Poppy-Robotics/vrb/vrb.pdf

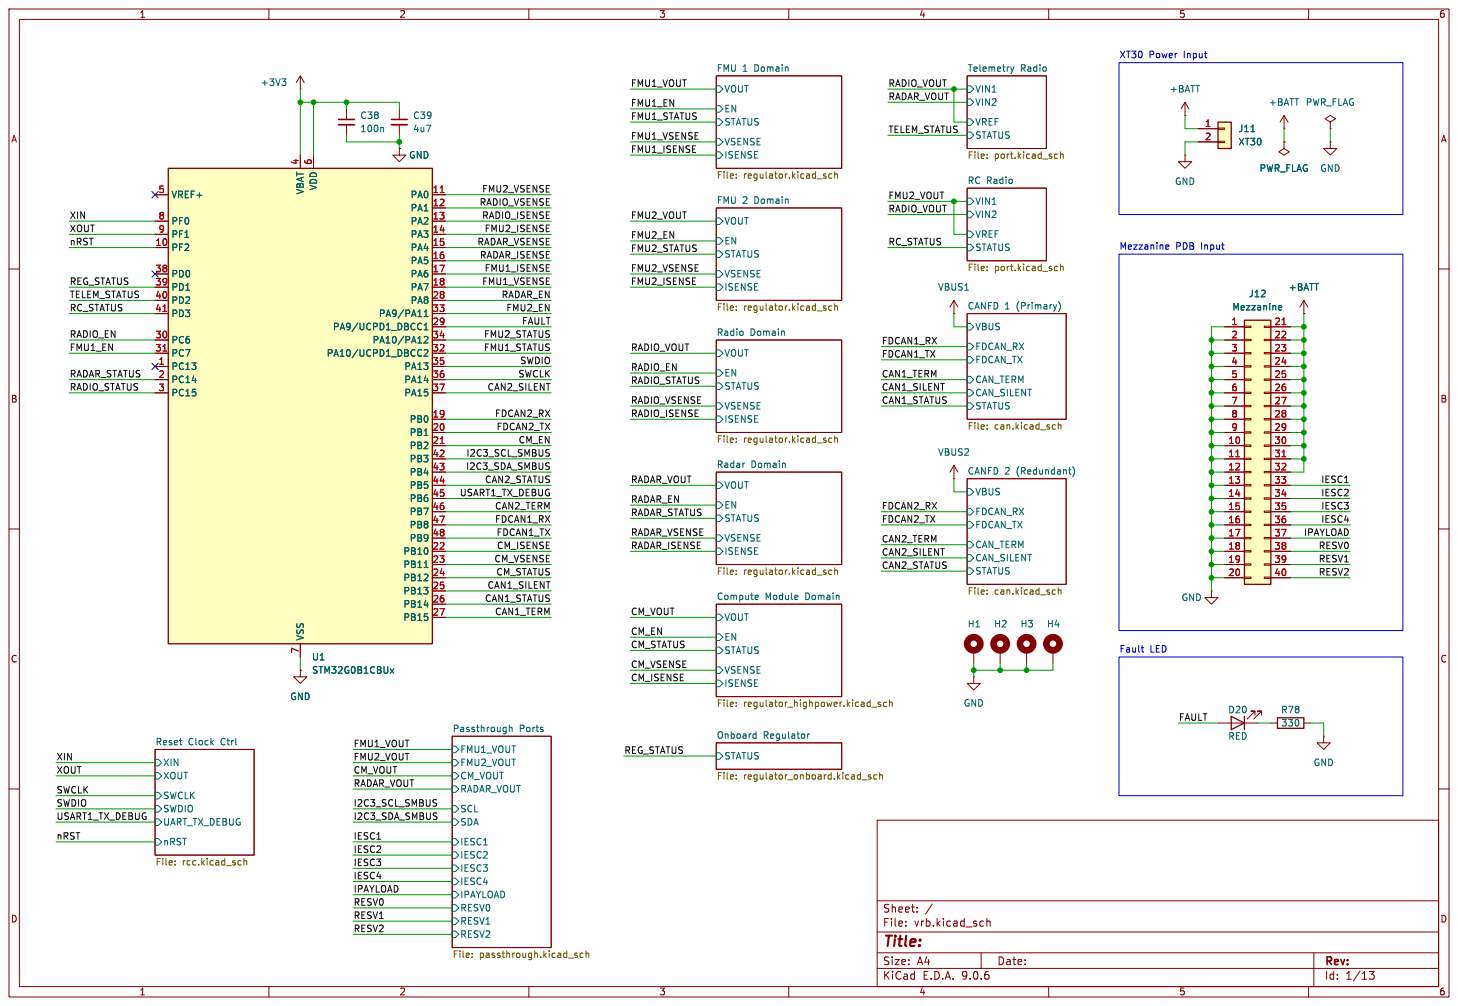
[picture p1: page 1]

+BATT GND
VBUS CANFD 1 (Primary) File: can.kicad_sch STATUS

FMU 1 Domain File: regulator.kicad_sch EN

VOUT VSENSE Compute Module Domain File: regulator_highpower.kicad_sch EN
STATUS

VIN1 VIN2 VREF RC Radio File: port.kicad_sch STATUS

FMU2_VSENSE
RADIO_VSENSE
FMU2_ISENSE RADIO_ISENSE RADAR_ISENSE
VOUT VSENSE Radar Domain File: regulator.kicad_sch STATUS Onboard Regulator File: regulator_onboard.kicad_sch EN

VOUT VSENSE Radio Domain File: regulator.kicad_sch CM_VOUT
FMU2_STATUS
FMU1_STATUS

VBUS CANFD 2 (Redundant) File: can.kicad_sch

Id: 1/13 Title: File: vrb.kicad_sch Sheet: /

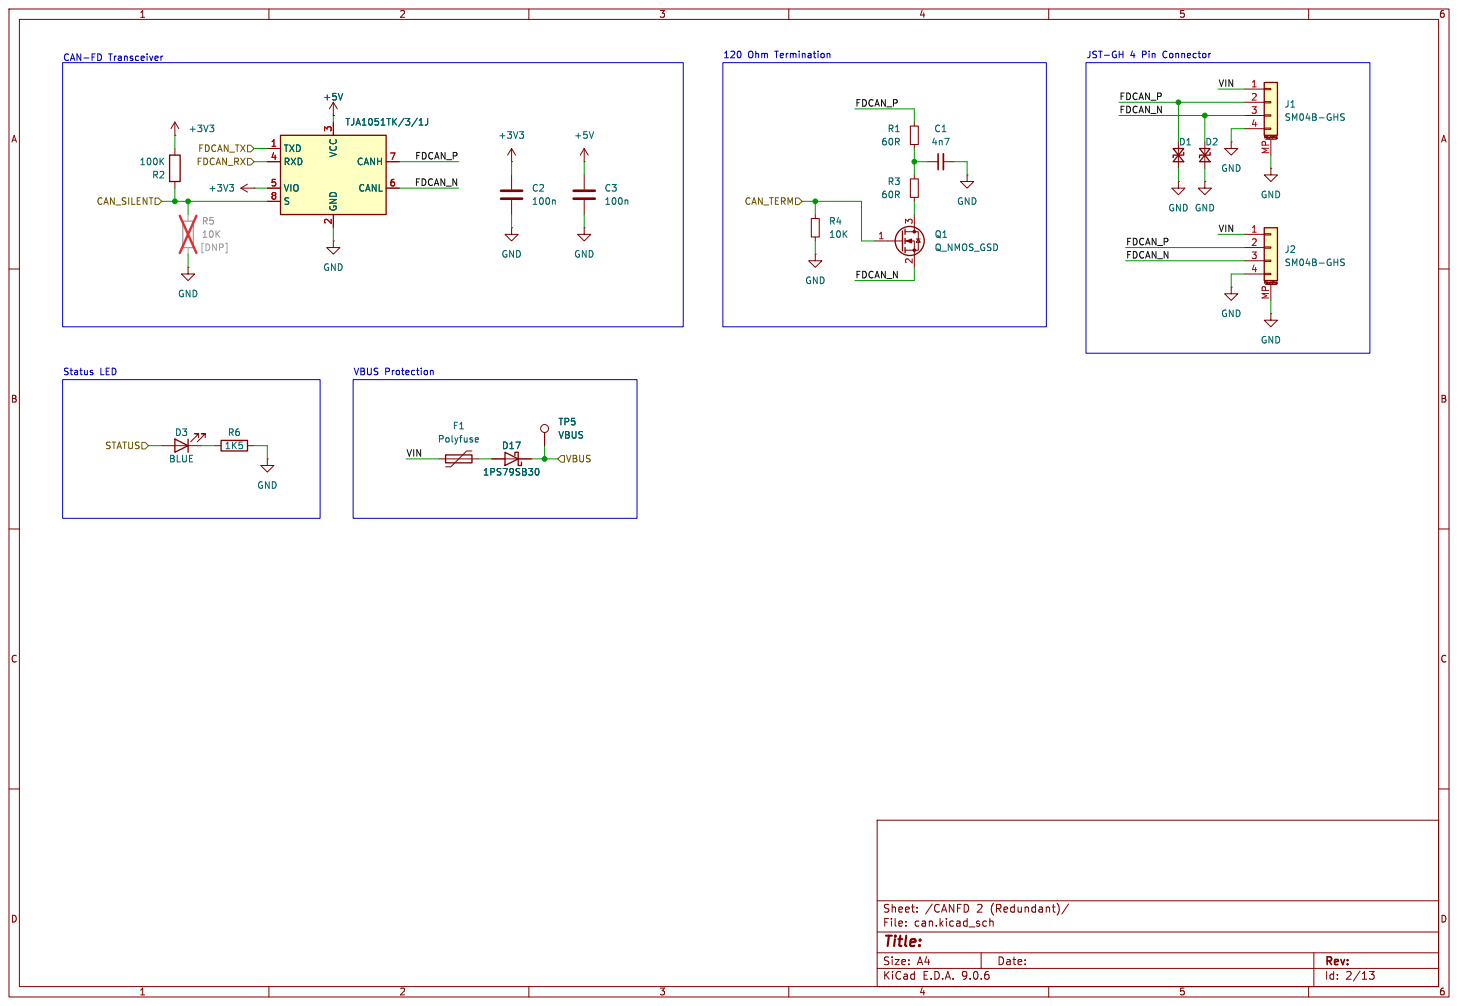
[picture p2: page 2]

2 CANH 7 CANL 6 TJA1051TK/3/1J +5V D1 D2 GND GND

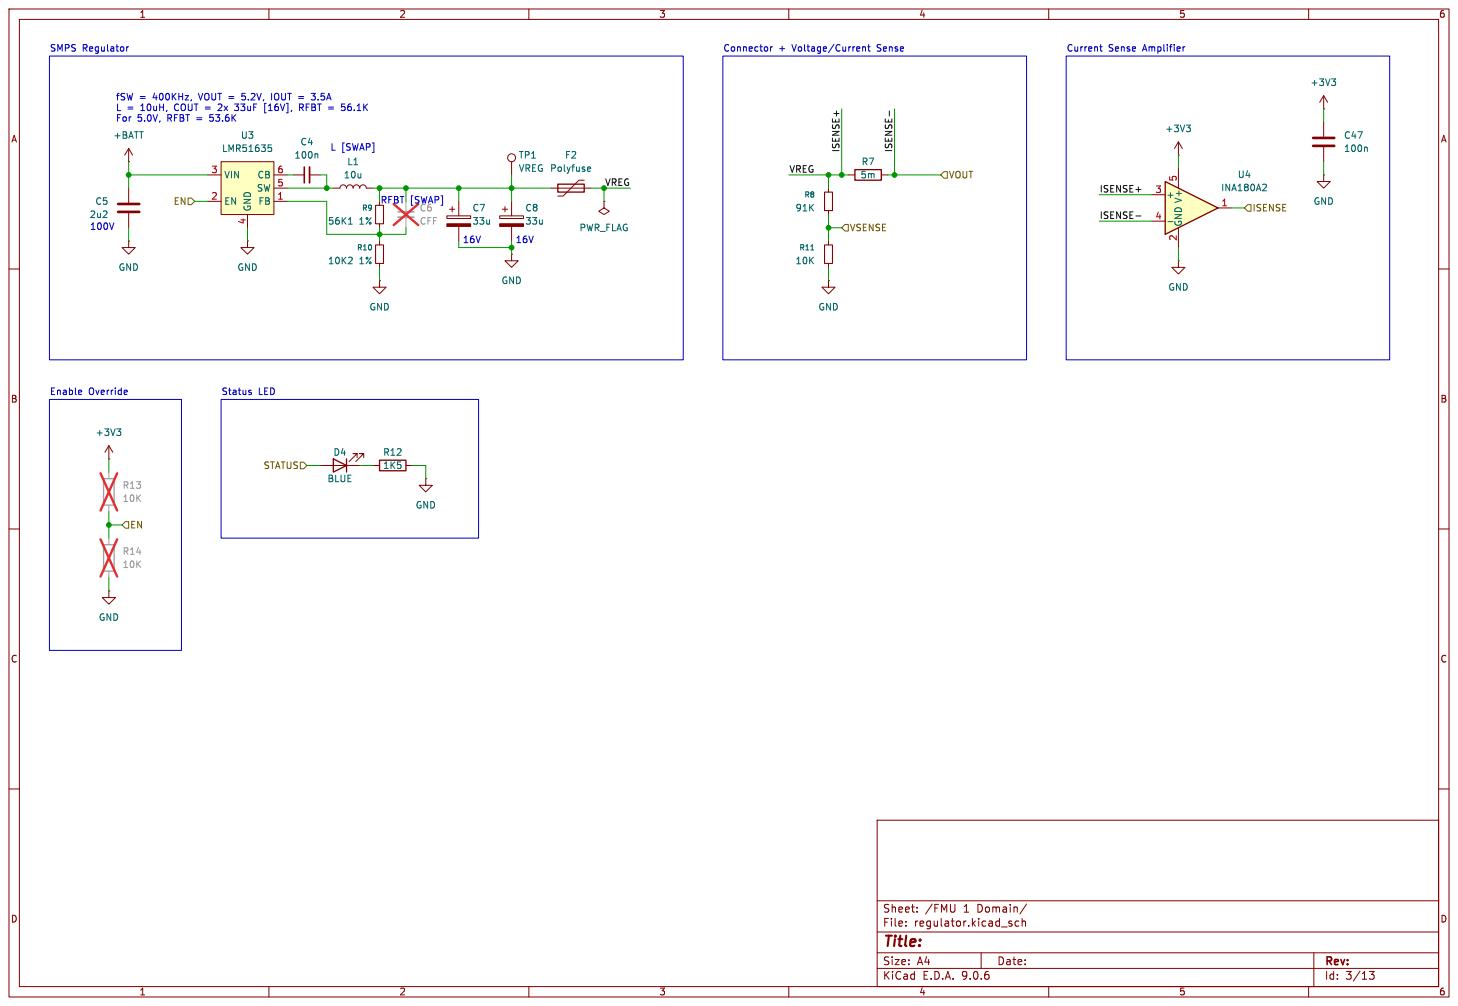
[picture p3: page 3]

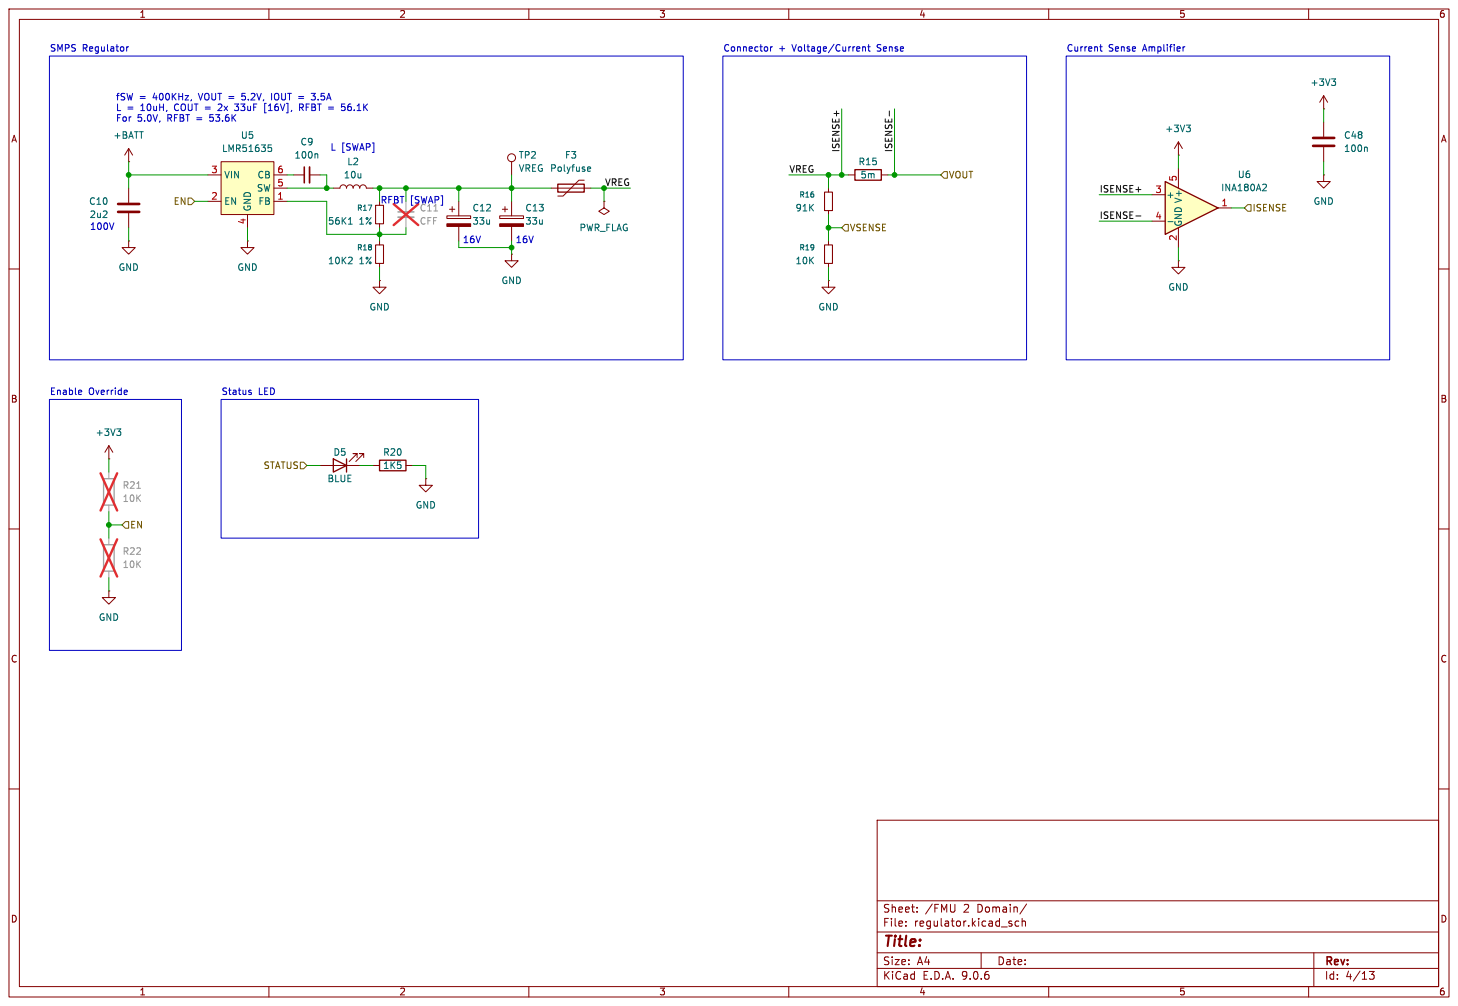
[picture p4: page 4]

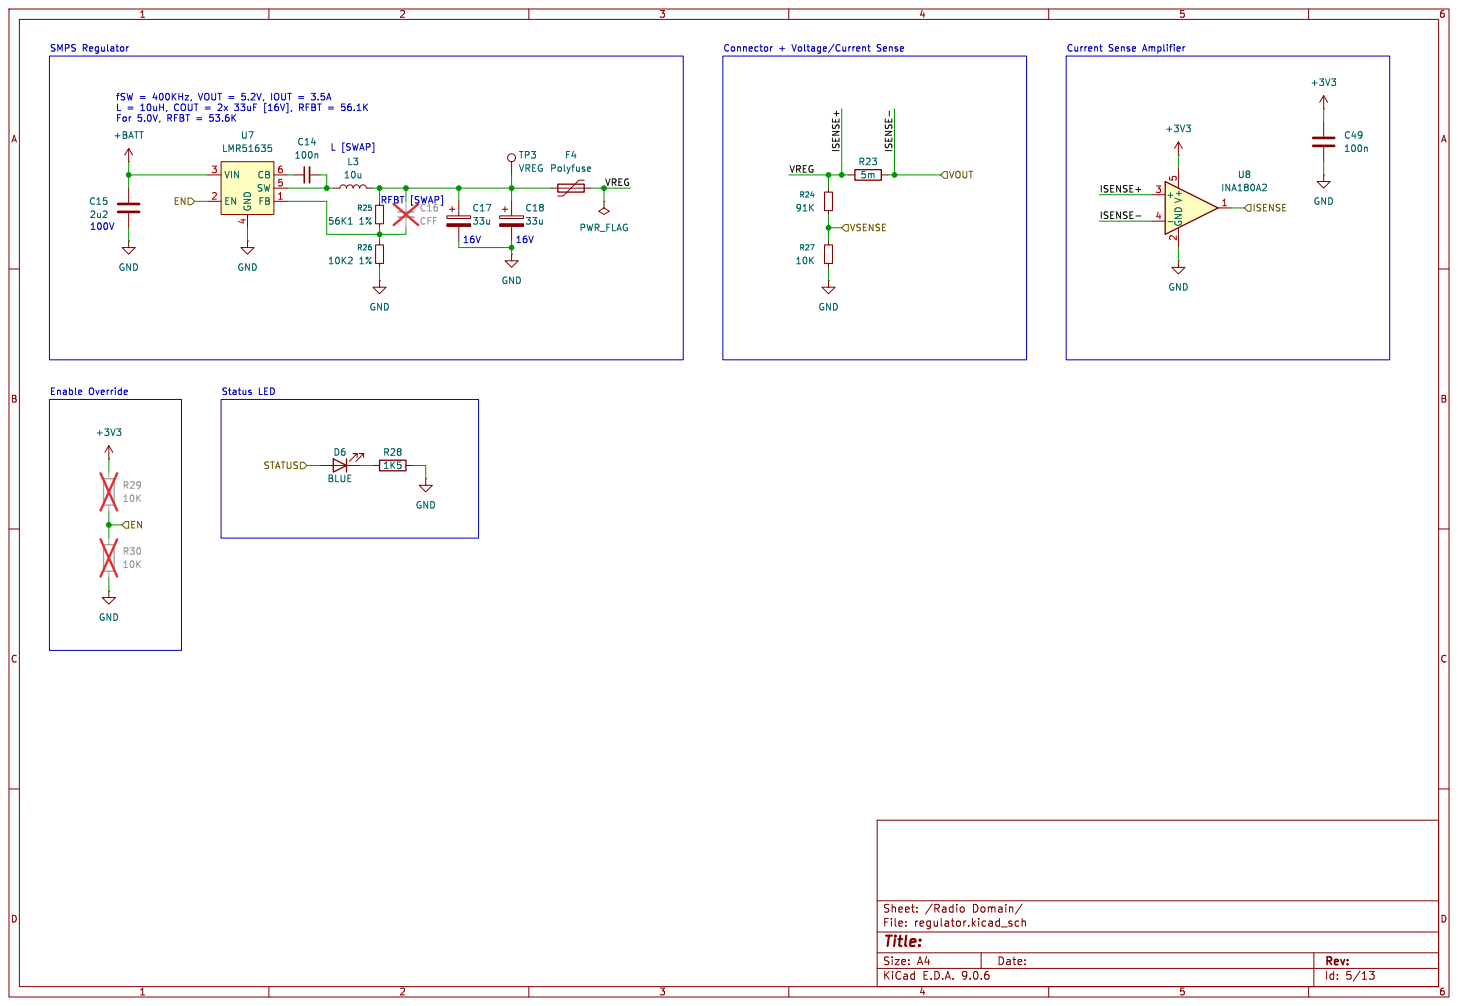
[picture p5: page 5]

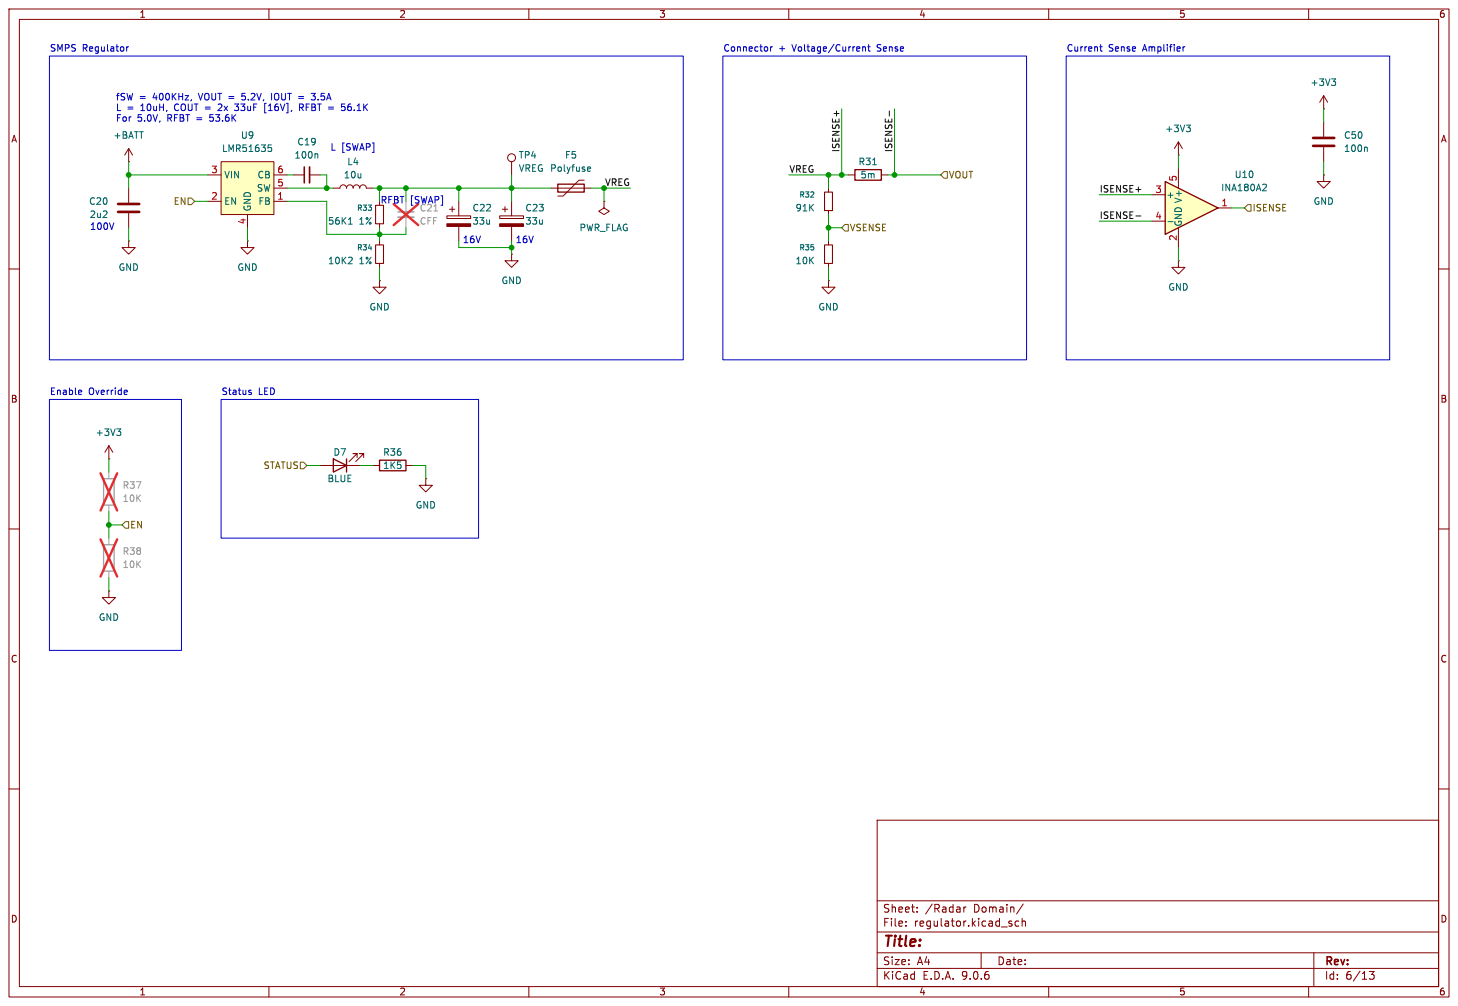
[picture p6: page 6]

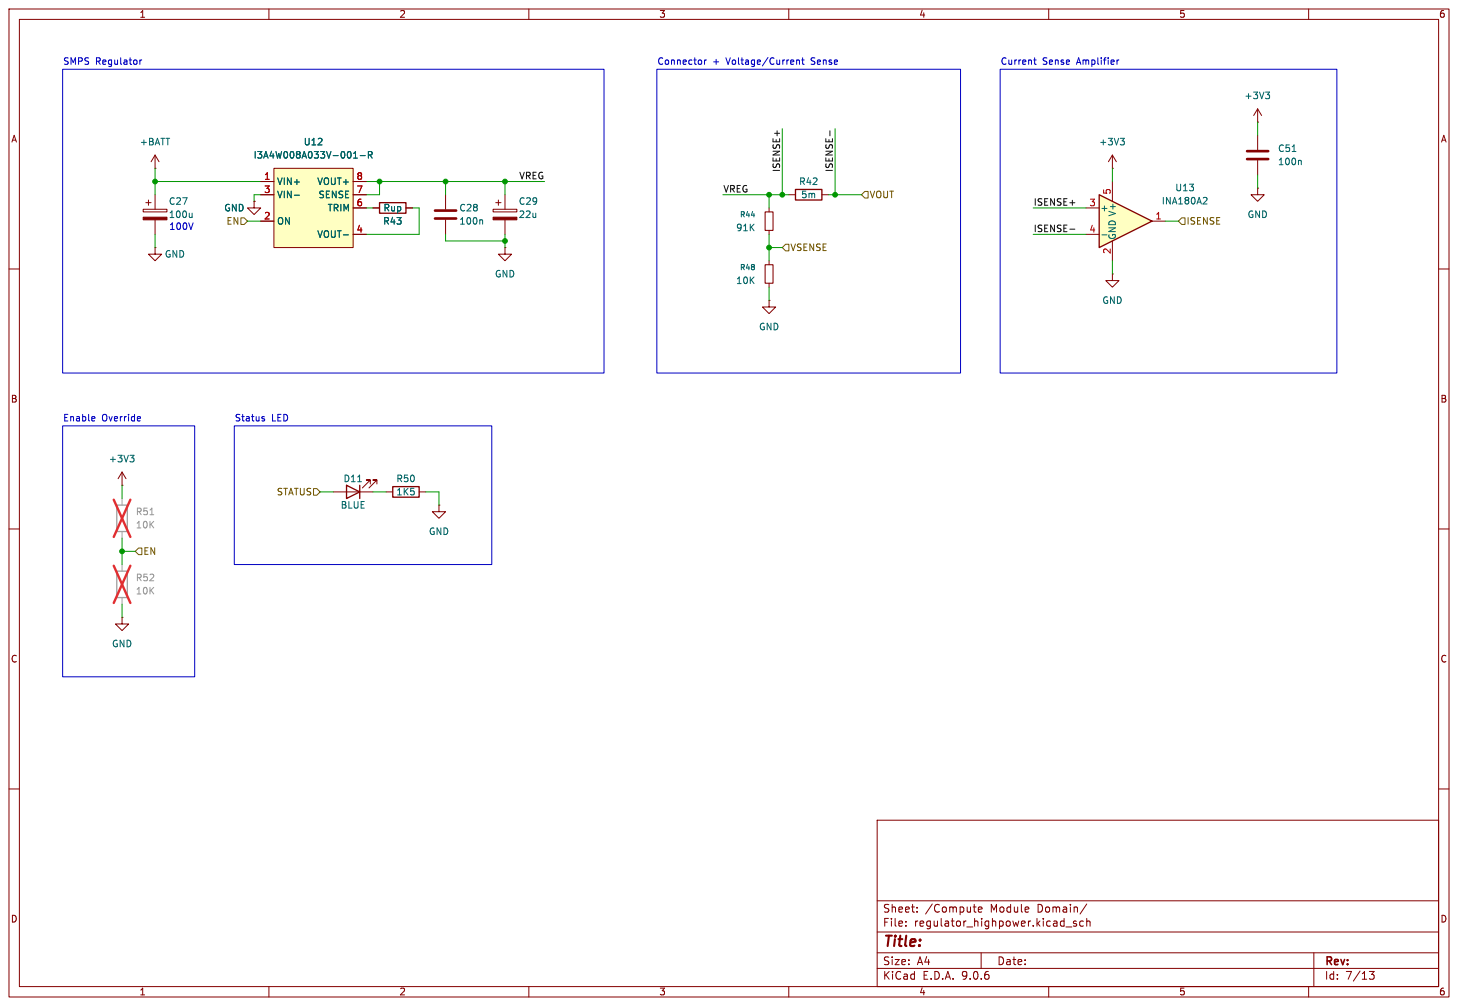
[picture p7: page 7]

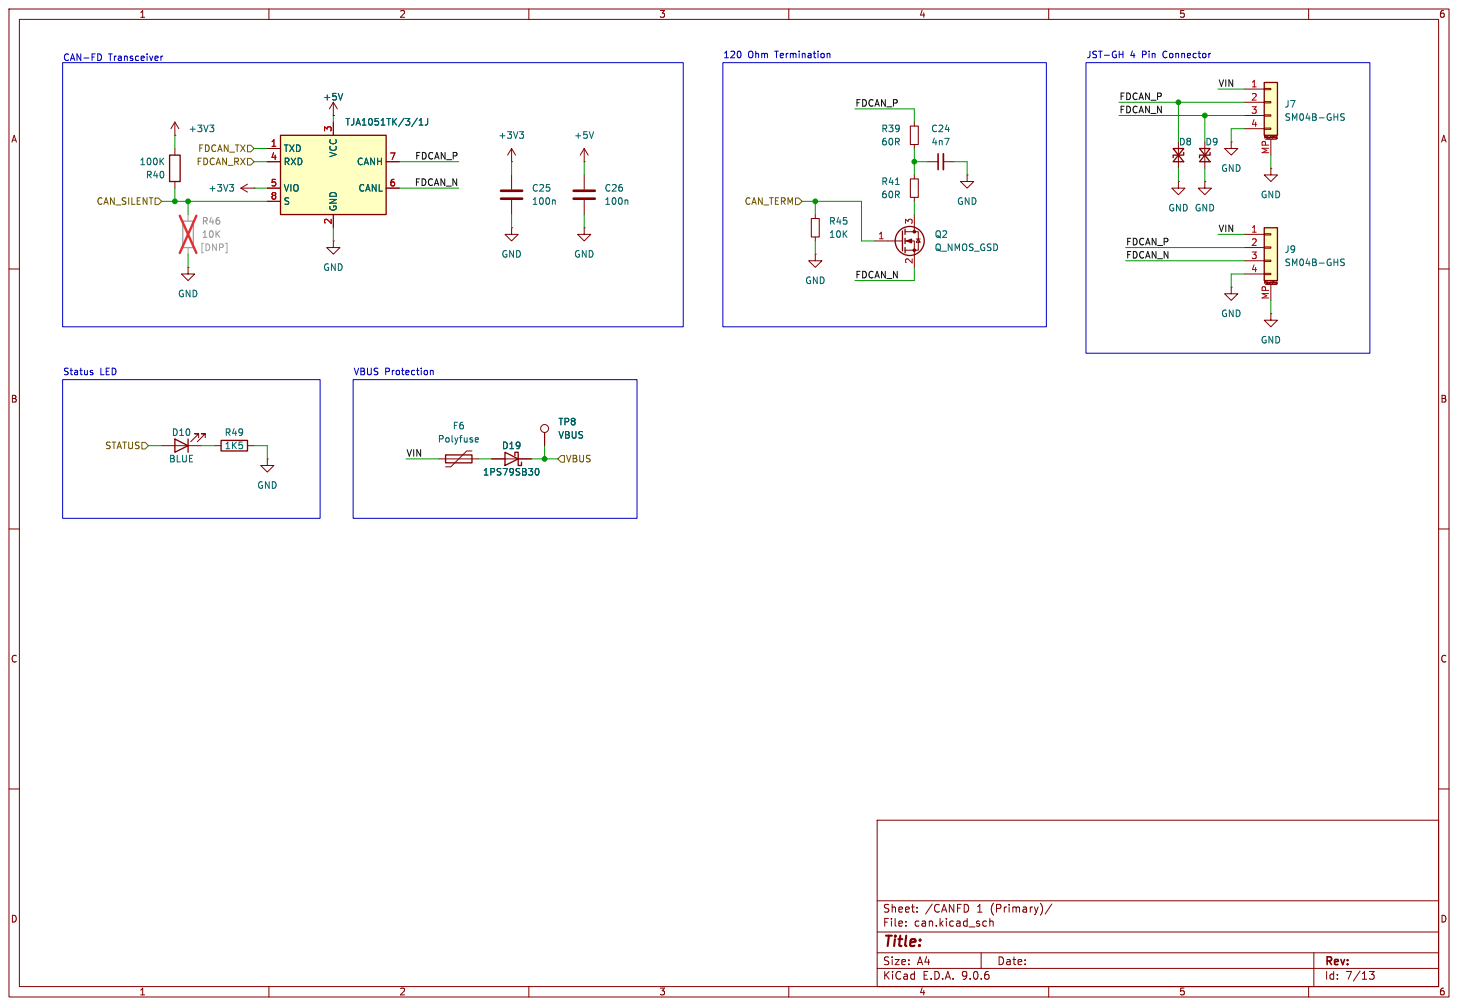
[picture p8: page 8]

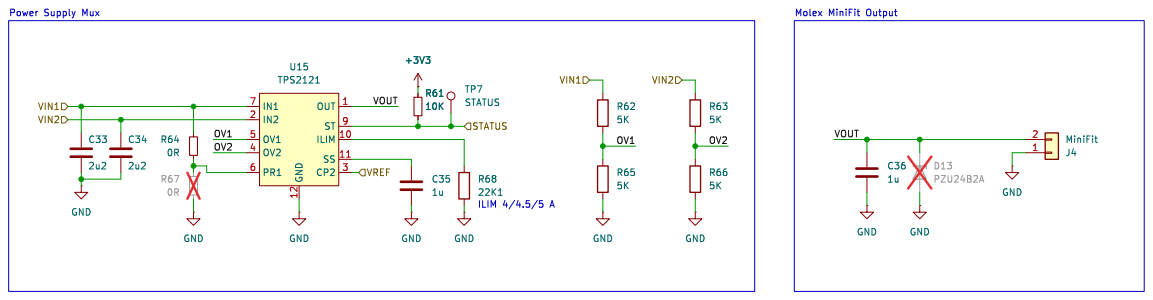
[picture p9: page 9]

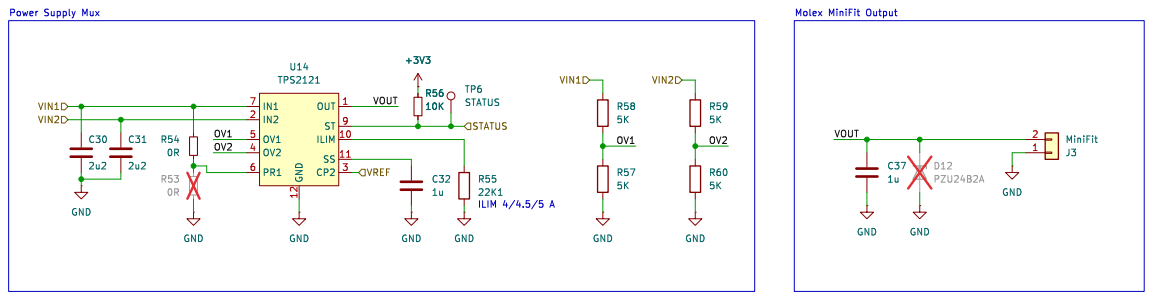
[picture p10: page 10]

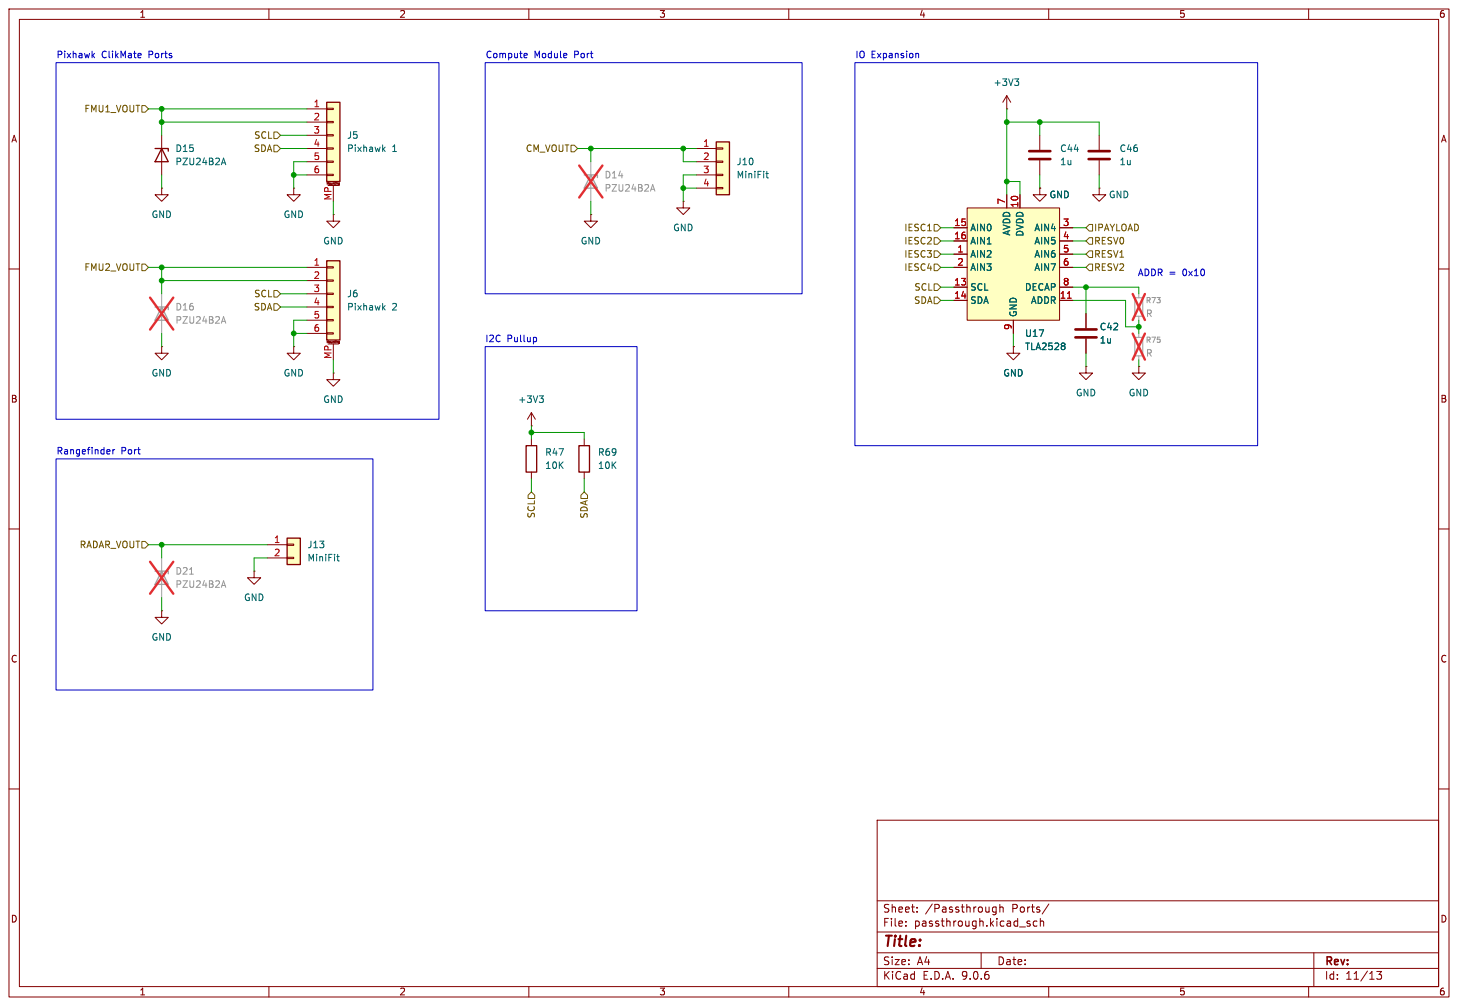
[picture p11: page 11]

9 DVDD 10 AIN4 3 AIN5 4 AIN6 5 AIN7 6 DECAP 8 ADDR 11 U17 TLA2528 GND GND

9 DVDD 10 AIN4 3 AIN5 4 AIN6 5 AIN7 6 DECAP 8 ADDR 11 GND

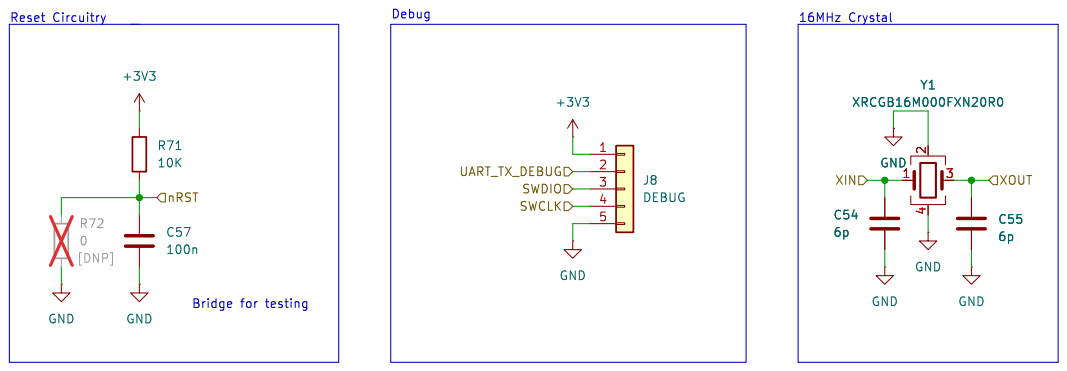
[picture p12: page 12]

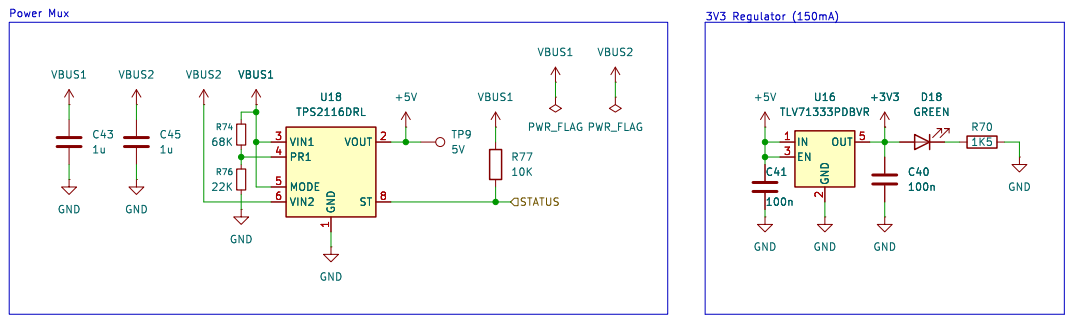
[picture p13: page 13]
