Poppy-Robotics/vrb/vrb.kicad_pcb

## KiCad design vrb.kicad_pcb (2026-01-10)

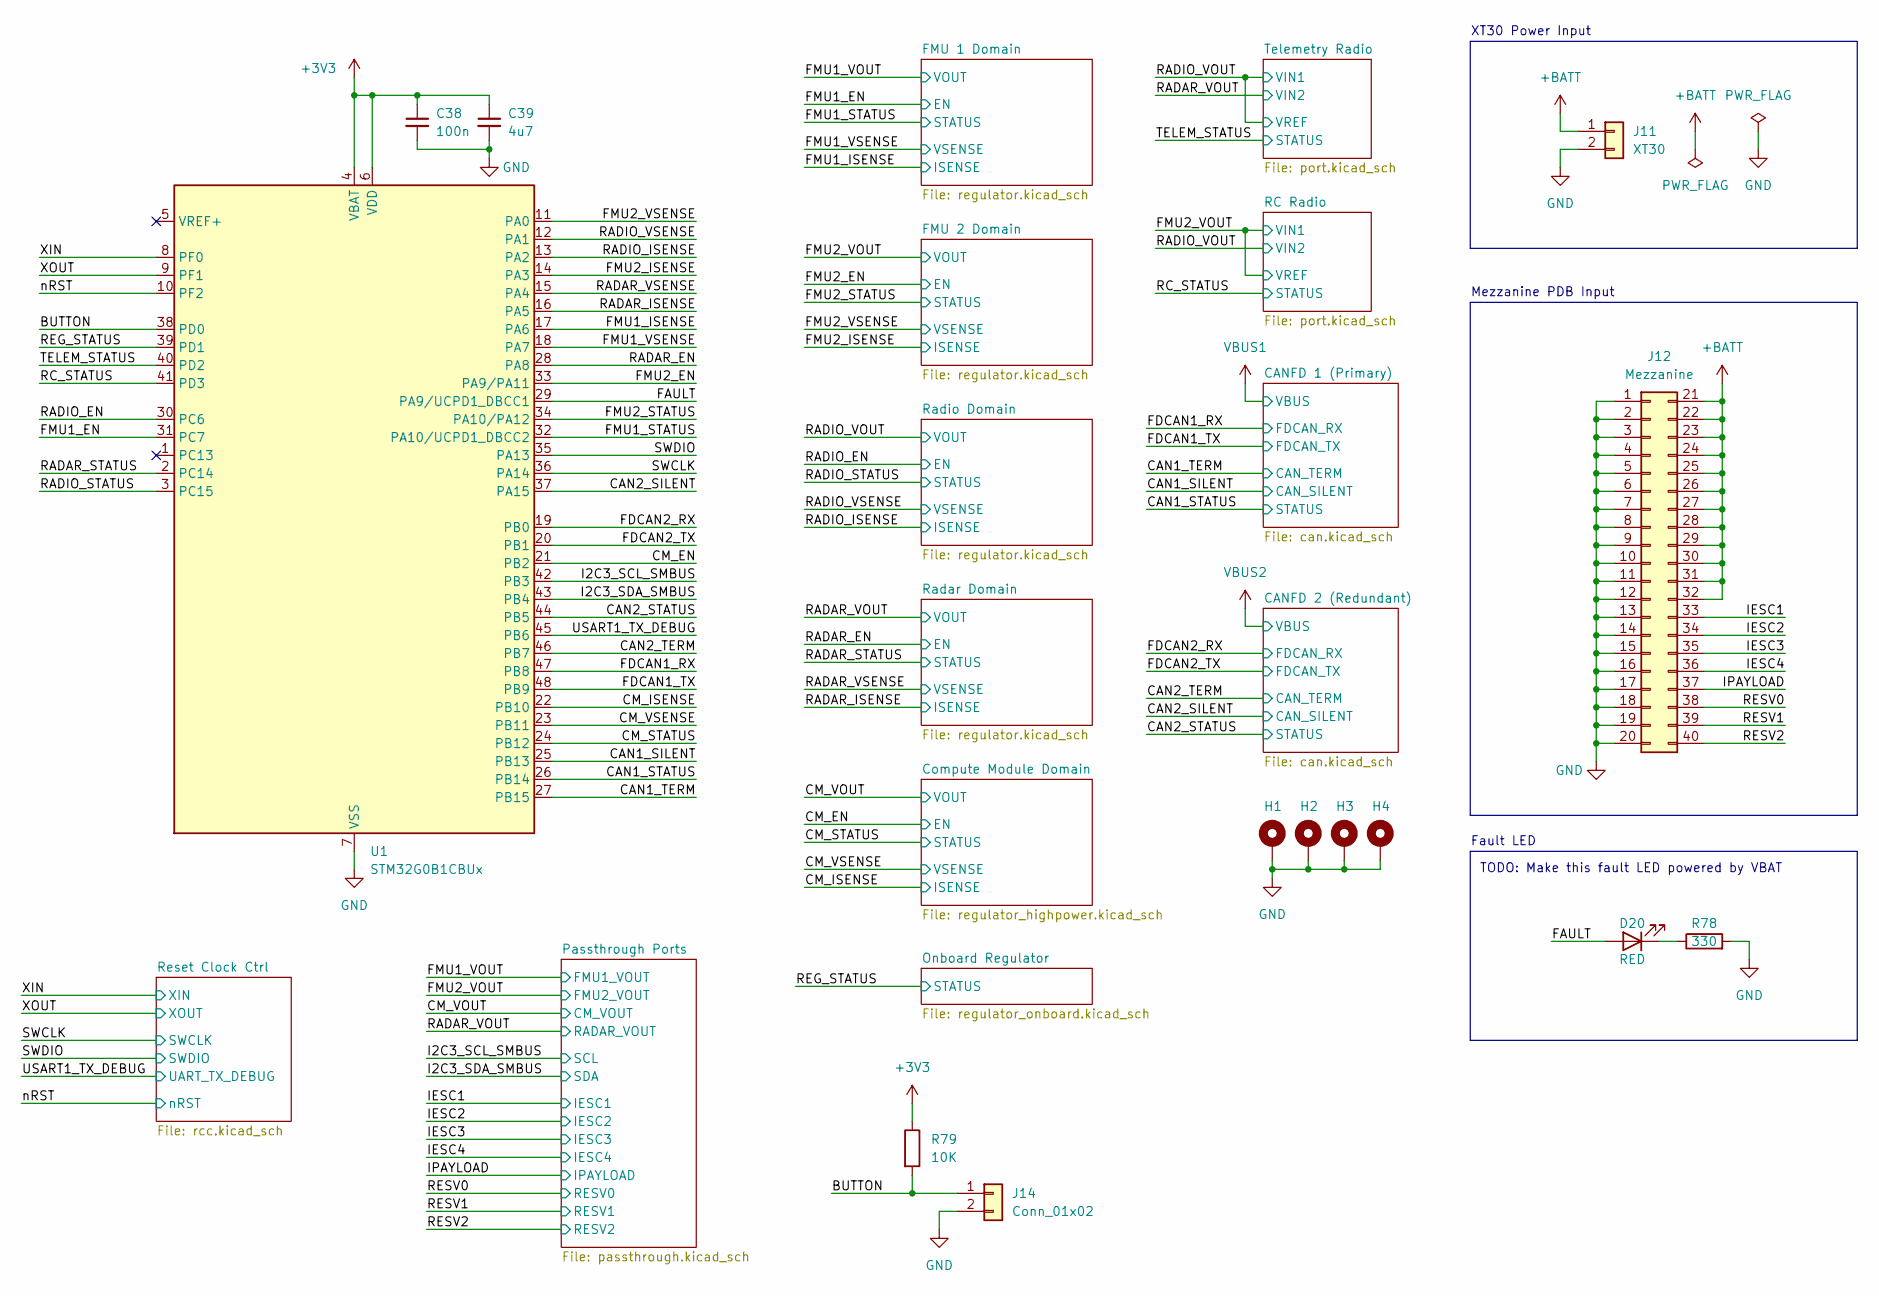
[picture p14: schematic vrb.kicad_sch]

Parts:
C38: 100n; C_0402_1005Metric
C39: 4u7; C_0402_1005Metric
D20: RED; LED_0603_1608Metric
H1, H2, H3, H4: MountingHole_Pad; MountingHole_3.2mm_M3_Pad_Via
J11: XT30; AMASS_XT30PW-M_1x02_P2.50mm_Horizontal
J12: Mezzanine; CON_528850474_MOL
J14: Conn_01x02; PinHeader_1x02_P2.54mm_Vertical
R78: 330; R_0402_1005Metric
R79: 10K; R_0402_1005Metric
U1: STM32G0B1CBUx; QFN-48-1EP_7x7mm_P0.5mm_EP5.6x5.6mm

Connections:
+BATT: J11.1, J12.21, J12.22, J12.23, J12.24, J12.25, J12.26, J12.27, J12.28, J12.29, J12.30, J12.31, J12.32; also elsewhere on the board
/BUTTON: J14.1, R79.2, U1.38 (PD0)
/CAN1_SILENT: U1.25 (PB13); also elsewhere on the board
/CAN1_STATUS: U1.26 (PB14); also elsewhere on the board
/CAN1_TERM: U1.27 (PB15); also elsewhere on the board
/CAN2_SILENT: U1.37 (PA15); also elsewhere on the board
/CAN2_STATUS: U1.44 (PB5); also elsewhere on the board
/CAN2_TERM: U1.46 (PB7); also elsewhere on the board
/CM_EN: U1.21 (PB2); also elsewhere on the board
/CM_ISENSE: U1.22 (PB10); also elsewhere on the board
/CM_STATUS: U1.24 (PB12); also elsewhere on the board
/CM_VSENSE: U1.23 (PB11); also elsewhere on the board
/FAULT: D20.2 (A), U1.29 (PA9/UCPD1_DBCC1)
/FDCAN1_RX: U1.47 (PB8); also elsewhere on the board
/FDCAN1_TX: U1.48 (PB9); also elsewhere on the board
/FDCAN2_RX: U1.19 (PB0); also elsewhere on the board
/FDCAN2_TX: U1.20 (PB1); also elsewhere on the board
/FMU1_EN: U1.31 (PC7); also elsewhere on the board
/FMU1_ISENSE: U1.17 (PA6); also elsewhere on the board
/FMU1_STATUS: U1.32 (PA10/UCPD1_DBCC2); also elsewhere on the board
/FMU1_VSENSE: U1.18 (PA7); also elsewhere on the board
/FMU2_EN: U1.33 (PA9/PA11); also elsewhere on the board
/FMU2_ISENSE: U1.14 (PA3); also elsewhere on the board
/FMU2_STATUS: U1.34 (PA10/PA12); also elsewhere on the board
/FMU2_VSENSE: U1.11 (PA0); also elsewhere on the board
/I2C3_SCL_SMBUS: U1.42 (PB3); also elsewhere on the board
/I2C3_SDA_SMBUS: U1.43 (PB4); also elsewhere on the board
/IESC1: J12.33; also elsewhere on the board
/IESC2: J12.34; also elsewhere on the board
/IESC3: J12.35; also elsewhere on the board
/IESC4: J12.36; also elsewhere on the board
/IPAYLOAD: J12.37; also elsewhere on the board
/RADAR_EN: U1.28 (PA8); also elsewhere on the board
/RADAR_ISENSE: U1.16 (PA5); also elsewhere on the board
/RADAR_STATUS: U1.2 (PC14); also elsewhere on the board
/RADAR_VSENSE: U1.15 (PA4); also elsewhere on the board
/RADIO_EN: U1.30 (PC6); also elsewhere on the board
/RADIO_ISENSE: U1.13 (PA2); also elsewhere on the board
/RADIO_STATUS: U1.3 (PC15); also elsewhere on the board
/RADIO_VSENSE: U1.12 (PA1); also elsewhere on the board
/RC_STATUS: U1.41 (PD3); also elsewhere on the board
/REG_STATUS: U1.39 (PD1); also elsewhere on the board
/RESV0: J12.38; also elsewhere on the board
/RESV1: J12.39; also elsewhere on the board
/RESV2: J12.40; also elsewhere on the board
/SWCLK: U1.36 (PA14); also elsewhere on the board
/SWDIO: U1.35 (PA13); also elsewhere on the board
/TELEM_STATUS: U1.40 (PD2); also elsewhere on the board
/USART1_TX_DEBUG: U1.45 (PB6); also elsewhere on the board
/XIN: U1.8 (PF0); also elsewhere on the board
/XOUT: U1.9 (PF1); also elsewhere on the board
/nRST: U1.10 (PF2); also elsewhere on the board
unnamed: D20.1 (K), R78.1

Notes on the sheet:
TODO: Make this fault LED powered by VBAT
Fault LED
XT30 Power Input
Mezzanine PDB Input

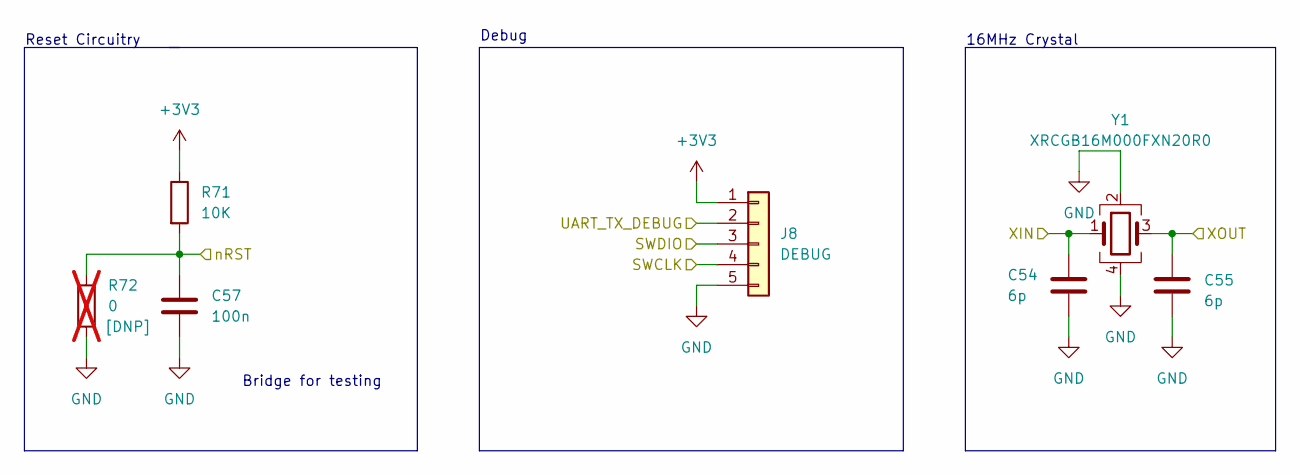
[picture p15: schematic rcc.kicad_sch]

Parts:
C54, C55: 6p; C_0402_1005Metric; LCSC C466231
C57: 100n; C_0402_1005Metric; LCSC C907967
J8: DEBUG; PinHeader_1x05_P2.54mm_Vertical
R71: 10K; R_0402_1005Metric; LCSC C102690
R72: 0; R_0402_1005Metric; not fitted
Y1: XRCGB16M000FXN20R0; Crystal_SMD_2016-4Pin_2.0x1.6mm; Part XRCGB16M000FXN20R0; LCSC C907977

Connections:
/SWCLK: J8.4; also elsewhere on the board
/SWDIO: J8.3; also elsewhere on the board
/USART1_TX_DEBUG: J8.2; also elsewhere on the board
/XIN: C54.1, Y1.1; also elsewhere on the board
/XOUT: C55.1, Y1.3; also elsewhere on the board
/nRST: C57.1, R71.2, R72.1; also elsewhere on the board

Notes on the sheet:
Reset Circuitry
Bridge for testing
16MHz Crystal
Debug

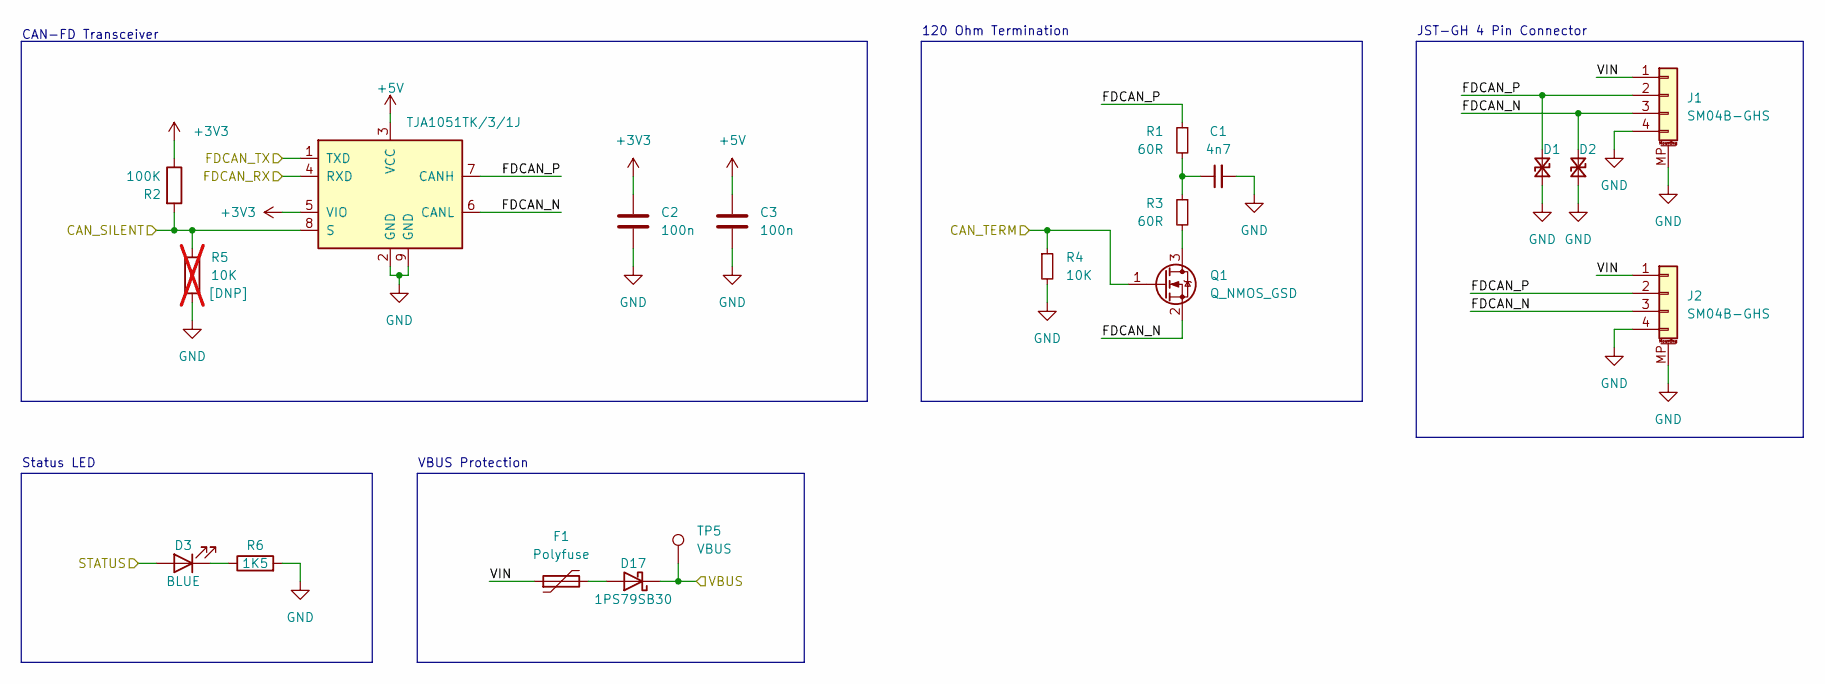
[picture p16: schematic can.kicad_sch]

Parts:
C1: 4n7; C_0402_1005Metric
C2, C3: 100n; C_0402_1005Metric
D1, D2: D_TVS_Small; Nexperia_DSN0603-2_0.6x0.3mm_P0.4mm
D3: BLUE; LED_0603_1608Metric
D17: 1PS79SB30; D_SOD-523; LCSC C426690
F1: Polyfuse; Fuse_1206_3216Metric
J1, J2: SM04B-GHS; JST_GH_SM04B-GHS-TB_1x04-1MP_P1.25mm_Horizontal
Q1: Q_NMOS_GSD; SOT-23-3
R1, R3: 60R; R_0402_1005Metric
R2: 100K; R_0402_1005Metric
R4: 10K; R_0402_1005Metric
R5: 10K; R_0402_1005Metric; not fitted
R6: 1K5; R_0402_1005Metric
TP5: VBUS; TestPoint_Pad_1.0x1.0mm
U2: TJA1051TK/3/1J; DFN-8-1EP_3x3mm_P0.65mm_EP1.55x2.4mm

Connections:
/CAN2_SILENT: R2.2, R5.1, U2.8 (S); also elsewhere on the board
/CAN2_STATUS: D3.2 (A); also elsewhere on the board
/CAN2_TERM: Q1.1 (G), R4.1; also elsewhere on the board
/CANFD 2 (Redundant)/FDCAN_N: D2.2 (A2), J1.3, J2.3, Q1.2 (S), U2.6 (CANL)
/CANFD 2 (Redundant)/FDCAN_P: D1.2 (A2), J1.2, J2.2, R1.1, U2.7 (CANH)
/CANFD 2 (Redundant)/VIN: F1.1, J1.1, J2.1
/FDCAN2_RX: U2.4 (RXD); also elsewhere on the board
/FDCAN2_TX: U2.1 (TXD); also elsewhere on the board
unnamed: C1.1, R1.2, R3.1
unnamed: D3.1 (K), R6.1
unnamed: D17.2 (A), F1.2
unnamed: Q1.3 (D), R3.2
VBUS2: D17.1 (K), TP5.1; also elsewhere on the board

Parts of its further copies:
C24: 4n7; C_0402_1005Metric
C25, C26: 100n; C_0402_1005Metric
D8, D9: D_TVS_Small; Nexperia_DSN0603-2_0.6x0.3mm_P0.4mm
D10: BLUE; LED_0603_1608Metric
D19: 1PS79SB30; D_SOD-523; LCSC C426690
F6: Polyfuse; Fuse_1206_3216Metric
J7, J9: SM04B-GHS; JST_GH_SM04B-GHS-TB_1x04-1MP_P1.25mm_Horizontal
Q2: Q_NMOS_GSD; SOT-23-3
R39, R41: 60R; R_0402_1005Metric
R40: 100K; R_0402_1005Metric
R45: 10K; R_0402_1005Metric
R46: 10K; R_0402_1005Metric; not fitted
R49: 1K5; R_0402_1005Metric
TP8: VBUS; TestPoint_Pad_1.0x1.0mm
U11: TJA1051TK/3/1J; DFN-8-1EP_3x3mm_P0.65mm_EP1.55x2.4mm

Connections of its further copies:
/CAN1_SILENT: R40.2, R46.1, U11.8 (S); also elsewhere on the board
/CAN1_STATUS: D10.2 (A); also elsewhere on the board
/CAN1_TERM: Q2.1 (G), R45.1; also elsewhere on the board
/CANFD 1 (Primary)/FDCAN_N: D9.2 (A2), J7.3, J9.3, Q2.2 (S), U11.6 (CANL)
/CANFD 1 (Primary)/FDCAN_P: D8.2 (A2), J7.2, J9.2, R39.1, U11.7 (CANH)
/CANFD 1 (Primary)/VIN: F6.1, J7.1, J9.1
/FDCAN1_RX: U11.4 (RXD); also elsewhere on the board
/FDCAN1_TX: U11.1 (TXD); also elsewhere on the board
unnamed: C24.1, R39.2, R41.1
unnamed: D10.1 (K), R49.1
unnamed: D19.2 (A), F6.2
unnamed: Q2.3 (D), R41.2
VBUS1: D19.1 (K), TP8.1; also elsewhere on the board

Notes on the sheet:
CAN-FD Transceiver
JST-GH 4 Pin Connector
Status LED
VBUS Protection
120 Ohm Termination

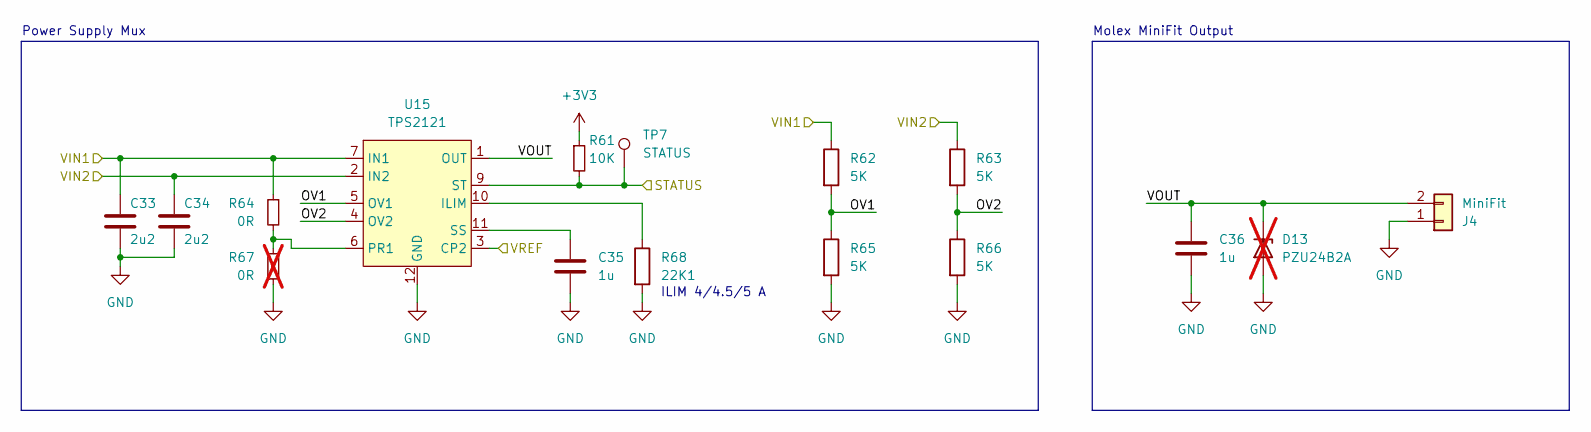
[picture p17: schematic port.kicad_sch]

Parts:
C33, C34: 2u2; C_0603_1608Metric
C35, C36: 1u; C_0603_1608Metric
D13: PZU24B2A; D_SOD-323F; not fitted
J4: MiniFit; Molex_Mini-Fit_Jr_5569-02A2_2x01_P4.20mm_Horizontal
R61: 10K; R_0402_1005Metric
R62, R63: 5K; R_0603_1608Metric
R64: 0R; R_0603_1608Metric
R65, R66: 5K; R_0402_1005Metric
R67: 0R; R_0402_1005Metric; not fitted
R68: 22K1; R_0603_1608Metric
TP7: STATUS; TestPoint_Pad_1.0x1.0mm
U15: TPS2121; Texas_VQFN-HR-12_2x2.5mm_P0.5mm

Connections:
/FMU2_VOUT: C33.1, R62.1, R64.1, U15.3 (CP2), U15.7 (IN1); also elsewhere on the board
/RADIO_VOUT: C34.1, R63.1, U15.2 (IN2); also elsewhere on the board
/RC Radio/OV1: R62.2, R65.1, U15.5 (OV1)
/RC Radio/OV2: R63.2, R66.1, U15.4 (OV2)
/RC Radio/VOUT: C36.1, D13.1 (K), J4.2, U15.1 (OUT), U15.8 (OUT)
/RC_STATUS: R61.2, TP7.1, U15.9 (ST); also elsewhere on the board
unnamed: R68.1, U15.10 (ILIM)
unnamed: R64.2, R67.1, U15.6 (PR1)
unnamed: C35.1, U15.11 (SS)

Parts of its further copies:
C30, C31: 2u2; C_0603_1608Metric
C32, C37: 1u; C_0603_1608Metric
D12: PZU24B2A; D_SOD-323F; not fitted
J3: MiniFit; Molex_Mini-Fit_Jr_5569-02A2_2x01_P4.20mm_Horizontal
R53: 0R; R_0402_1005Metric; not fitted
R54: 0R; R_0603_1608Metric
R55: 22K1; R_0603_1608Metric
R56: 10K; R_0402_1005Metric
R57, R60: 5K; R_0402_1005Metric
R58, R59: 5K; R_0603_1608Metric
TP6: STATUS; TestPoint_Pad_1.0x1.0mm
U14: TPS2121; Texas_VQFN-HR-12_2x2.5mm_P0.5mm

Connections of its further copies:
/RADAR_VOUT: C31.1, R59.1, U14.2 (IN2); also elsewhere on the board
/RADIO_VOUT: C30.1, R54.1, R58.1, U14.3 (CP2), U14.7 (IN1); also elsewhere on the board
/TELEM_STATUS: R56.2, TP6.1, U14.9 (ST); also elsewhere on the board
/Telemetry Radio/OV1: R57.1, R58.2, U14.5 (OV1)
/Telemetry Radio/OV2: R59.2, R60.1, U14.4 (OV2)
/Telemetry Radio/VOUT: C37.1, D12.1 (K), J3.2, U14.1 (OUT), U14.8 (OUT)
unnamed: R55.1, U14.10 (ILIM)
unnamed: R53.1, R54.2, U14.6 (PR1)
unnamed: C32.1, U14.11 (SS)

Notes on the sheet:
Molex MiniFit Output
Power Supply Mux
ILIM 4/4.5/5 A

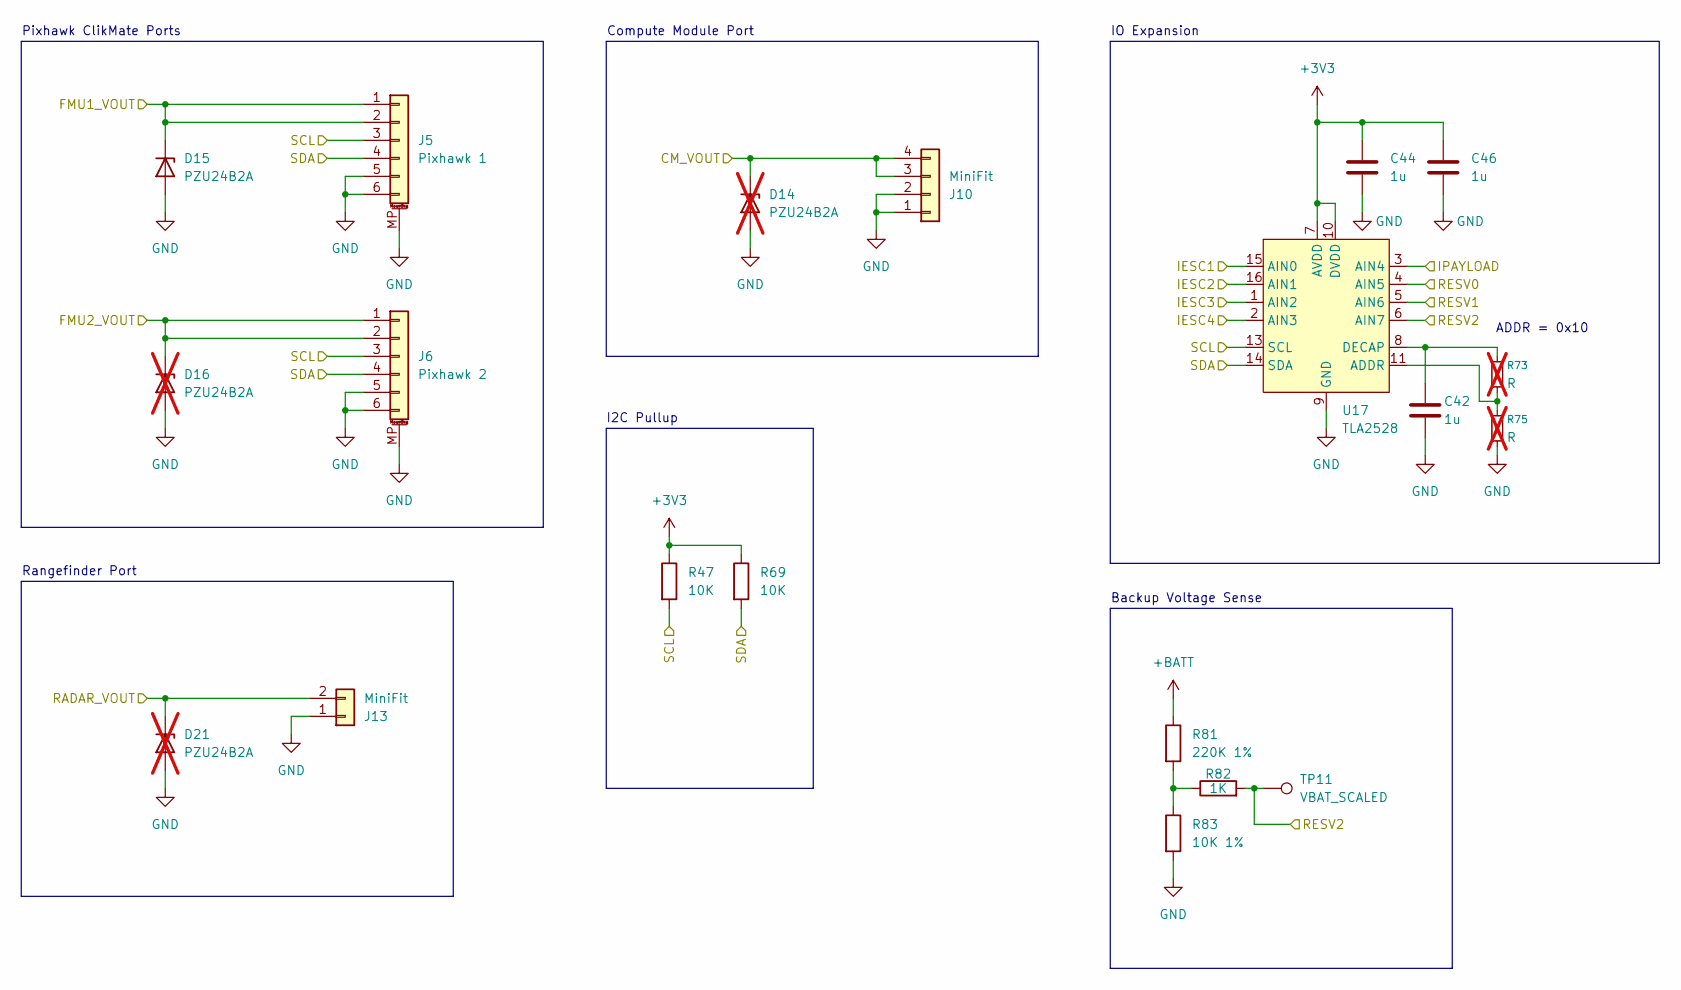
[picture p18: schematic passthrough.kicad_sch]

Parts:
C42, C44, C46: 1u; C_0402_1005Metric
D14, D16, D21: PZU24B2A; D_SOD-323F; not fitted
D15: PZU24B2A; D_SOD-323F
J5: Pixhawk 1; Molex_CLIK-Mate_502494-0670_1x06-1MP_P2.00mm_Horizontal
J6: Pixhawk 2; Molex_CLIK-Mate_502494-0670_1x06-1MP_P2.00mm_Horizontal
J10: MiniFit; Molex_Mini-Fit_Jr_5569-04A2_2x02_P4.20mm_Horizontal
J13: MiniFit; Molex_Mini-Fit_Jr_5569-02A2_2x01_P4.20mm_Horizontal
R47, R69: 10K; R_0402_1005Metric
R73, R75: R; R_0402_1005Metric; not fitted
R81: 220K 1%; R_0603_1608Metric
R82: 1K; R_0603_1608Metric
R83: 10K 1%; R_0603_1608Metric
TP11: VBAT_SCALED; TestPoint_Pad_1.5x1.5mm
U17: TLA2528; WQFN-16-1EP_3x3mm_P0.5mm_EP1.68x1.68mm

Connections:
+BATT: R81.1; also elsewhere on the board
/CM_VOUT: D14.1 (K), J10.3, J10.4; also elsewhere on the board
/FMU1_VOUT: D15.1 (K), J5.1, J5.2; also elsewhere on the board
/FMU2_VOUT: D16.1 (K), J6.1, J6.2; also elsewhere on the board
/I2C3_SCL_SMBUS: J5.3, J6.3, R47.2, U17.13 (SCL); also elsewhere on the board
/I2C3_SDA_SMBUS: J5.4, J6.4, R69.2, U17.14 (SDA); also elsewhere on the board
/IESC1: U17.15 (AIN0); also elsewhere on the board
/IESC2: U17.16 (AIN1); also elsewhere on the board
/IESC3: U17.1 (AIN2); also elsewhere on the board
/IESC4: U17.2 (AIN3); also elsewhere on the board
/IPAYLOAD: U17.3 (AIN4); also elsewhere on the board
/RADAR_VOUT: D21.1 (K), J13.2; also elsewhere on the board
/RESV0: U17.4 (AIN5); also elsewhere on the board
/RESV1: U17.5 (AIN6); also elsewhere on the board
/RESV2: R82.2, TP11.1, U17.6 (AIN7); also elsewhere on the board
unnamed: R81.2, R82.1, R83.1
unnamed: R73.2, R75.1, U17.11 (ADDR)
unnamed: C42.1, R73.1, U17.8 (DECAP)

Notes on the sheet:
Pixhawk ClikMate Ports
I2C Pullup
Rangefinder Port
Backup Voltage Sense
ADDR = 0x10
Compute Module Port
IO Expansion

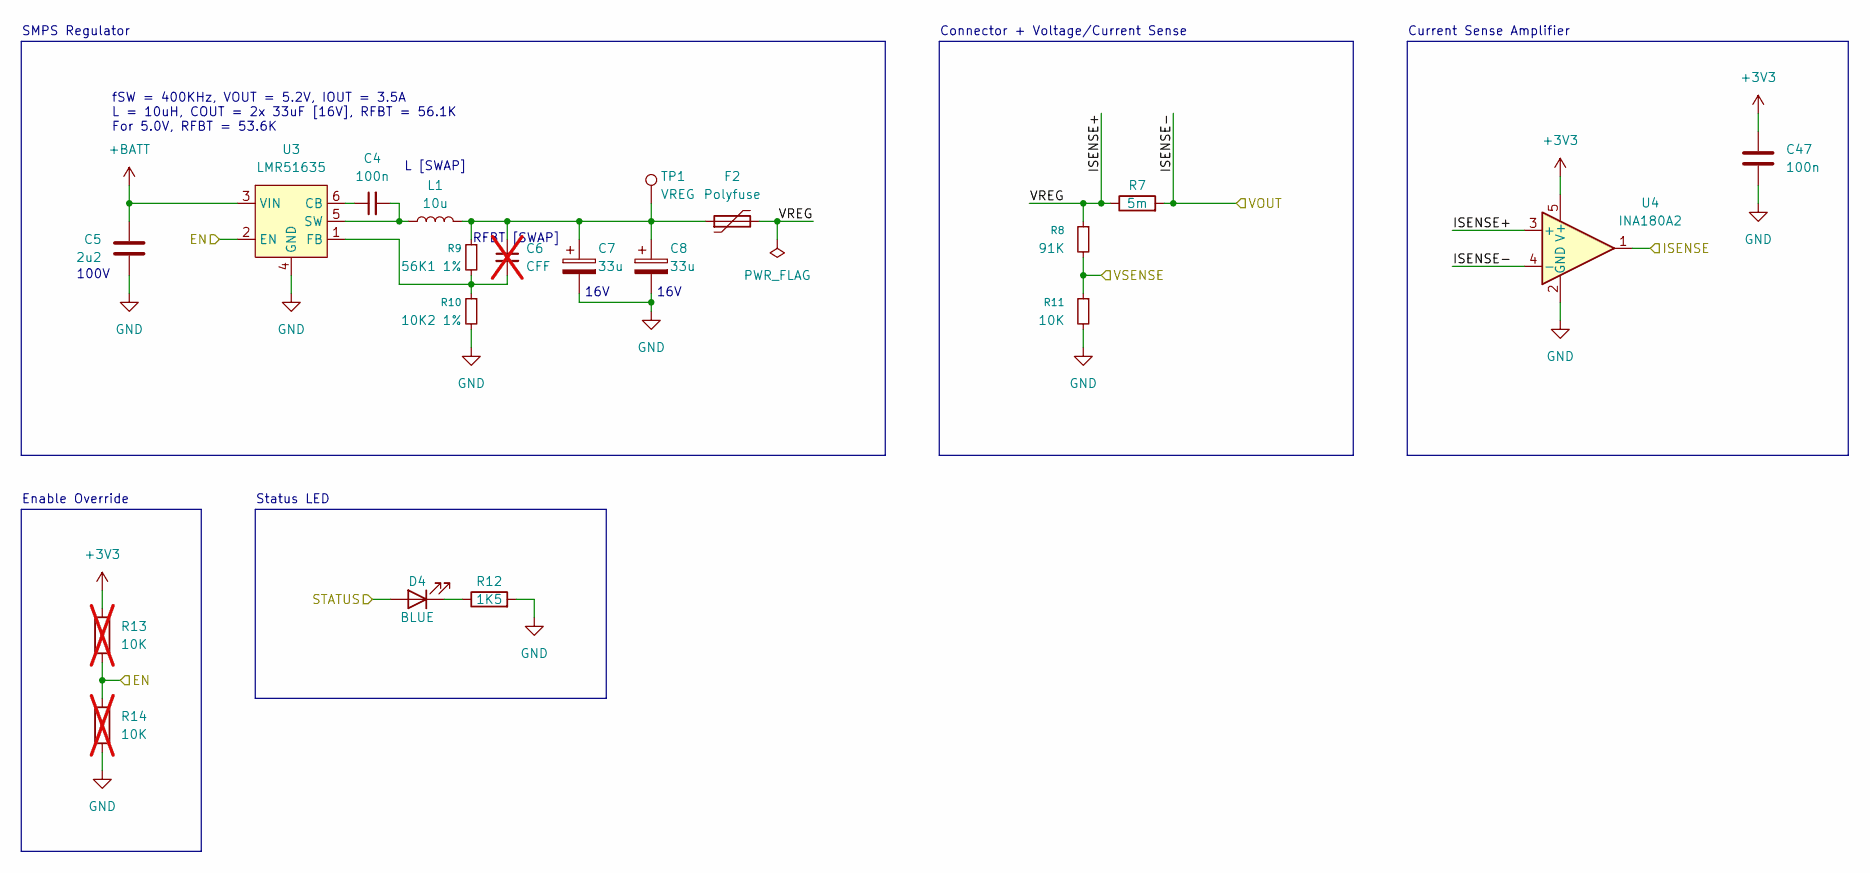
[picture p19: schematic regulator.kicad_sch]

Parts:
C4: 100n; C_0805_2012Metric
C5: 2u2; C_1206_3216Metric
C6: CFF; C_0805_2012Metric; not fitted
C7, C8: 33u; CP_EIA-3528-12_Kemet-T
C47: 100n; C_0402_1005Metric
D4: BLUE; LED_0603_1608Metric
F2: Polyfuse; Fuse_1206_3216Metric
L1: 10u; L_Bourns_SRP7028A_7.3x6.6mm
R7: 5m; R_1206_3216Metric
R8: 91K; R_0402_1005Metric
R9: 56K1 1%; R_0603_1608Metric
R10: 10K2 1%; R_0603_1608Metric
R11: 10K; R_0402_1005Metric
R12: 1K5; R_0402_1005Metric
R13, R14: 10K; R_0603_1608Metric; not fitted
TP1: VREG; TestPoint_Pad_2.0x2.0mm
U3: LMR51635; SOT-23-6
U4: INA180A2; SOT-23-5

Connections:
+BATT: C5.1, U3.3 (VIN); also elsewhere on the board
/FMU1_EN: R13.2, R14.1, U3.2 (EN); also elsewhere on the board
/FMU1_ISENSE: U4.1; also elsewhere on the board
/FMU1_STATUS: D4.2 (A); also elsewhere on the board
/FMU1_VOUT: R7.2, U4.4 (-); also elsewhere on the board
/FMU1_VSENSE: R8.2, R11.1; also elsewhere on the board
/FMU 1 Domain/ISENSE+: F2.2, R7.1, R8.1, U4.3 (+)
unnamed: C6.1, C7.1, C8.1, F2.1, L1.2, R9.1, TP1.1
unnamed: D4.1 (K), R12.1
unnamed: C4.1, U3.6 (CB)
unnamed: C6.2, R9.2, R10.1, U3.1 (FB)
unnamed: C4.2, L1.1, U3.5 (SW)

Parts of its further copies:
C9, C14, C19: 100n; C_0805_2012Metric
C10, C15, C20: 2u2; C_1206_3216Metric
C11, C16, C21: CFF; C_0805_2012Metric; not fitted
C12, C13, C17, C18, C22, C23: 33u; CP_EIA-3528-12_Kemet-T
C48, C49, C50: 100n; C_0402_1005Metric
D5, D6, D7: BLUE; LED_0603_1608Metric
F3, F4, F5: Polyfuse; Fuse_1206_3216Metric
L2, L3, L4: 10u; L_Bourns_SRP7028A_7.3x6.6mm
R15, R23, R31: 5m; R_1206_3216Metric
R16, R24, R32: 91K; R_0402_1005Metric
R17, R25, R33: 56K1 1%; R_0603_1608Metric
R18, R26, R34: 10K2 1%; R_0603_1608Metric
R19, R27, R35: 10K; R_0402_1005Metric
R20, R28, R36: 1K5; R_0402_1005Metric
R21, R22, R29, R30, R37, R38: 10K; R_0603_1608Metric; not fitted
TP2, TP3, TP4: VREG; TestPoint_Pad_2.0x2.0mm
U5, U7, U9: LMR51635; SOT-23-6
U6, U8, U10: INA180A2; SOT-23-5

Connections of its further copies:
+BATT: C10.1, C15.1, C20.1, U5.3 (VIN), U7.3 (VIN), U9.3 (VIN); also elsewhere on the board
/FMU2_EN: R21.2, R22.1, U5.2 (EN); also elsewhere on the board
/FMU2_ISENSE: U6.1; also elsewhere on the board
/FMU2_STATUS: D5.2 (A); also elsewhere on the board
/FMU2_VOUT: R15.2, U6.4 (-); also elsewhere on the board
/FMU2_VSENSE: R16.2, R19.1; also elsewhere on the board
/FMU 2 Domain/ISENSE+: F3.2, R15.1, R16.1, U6.3 (+)
/RADAR_EN: R37.2, R38.1, U9.2 (EN); also elsewhere on the board
/RADAR_ISENSE: U10.1; also elsewhere on the board
/RADAR_STATUS: D7.2 (A); also elsewhere on the board
/RADAR_VOUT: R31.2, U10.4 (-); also elsewhere on the board
/RADAR_VSENSE: R32.2, R35.1; also elsewhere on the board
/RADIO_EN: R29.2, R30.1, U7.2 (EN); also elsewhere on the board
/RADIO_ISENSE: U8.1; also elsewhere on the board
/RADIO_STATUS: D6.2 (A); also elsewhere on the board
/RADIO_VOUT: R23.2, U8.4 (-); also elsewhere on the board
/RADIO_VSENSE: R24.2, R27.1; also elsewhere on the board
/Radar Domain/ISENSE+: F5.2, R31.1, R32.1, U10.3 (+)
/Radio Domain/ISENSE+: F4.2, R23.1, R24.1, U8.3 (+)
unnamed: C11.1, C12.1, C13.1, F3.1, L2.2, R17.1, TP2.1
unnamed: C16.1, C17.1, C18.1, F4.1, L3.2, R25.1, TP3.1
unnamed: C21.1, C22.1, C23.1, F5.1, L4.2, R33.1, TP4.1
unnamed: D5.1 (K), R20.1
unnamed: D6.1 (K), R28.1
unnamed: D7.1 (K), R36.1
unnamed: C9.1, U5.6 (CB)
unnamed: C11.2, R17.2, R18.1, U5.1 (FB)
unnamed: C9.2, L2.1, U5.5 (SW)
unnamed: C14.1, U7.6 (CB)
unnamed: C16.2, R25.2, R26.1, U7.1 (FB)
unnamed: C14.2, L3.1, U7.5 (SW)
unnamed: C19.1, U9.6 (CB)
unnamed: C21.2, R33.2, R34.1, U9.1 (FB)
unnamed: C19.2, L4.1, U9.5 (SW)

Notes on the sheet:
Enable Override
16V
Status LED
Current Sense Amplifier
L [SWAP]
RFBT [SWAP]
SMPS Regulator
Connector + Voltage/Current Sense
fSW = 400KHz, VOUT = 5.2V, IOUT = 3.5A L = 10uH, COUT = 2x 33uF [16V], RFBT = 56.1K For 5.0V, RFBT = 53.6K
100V

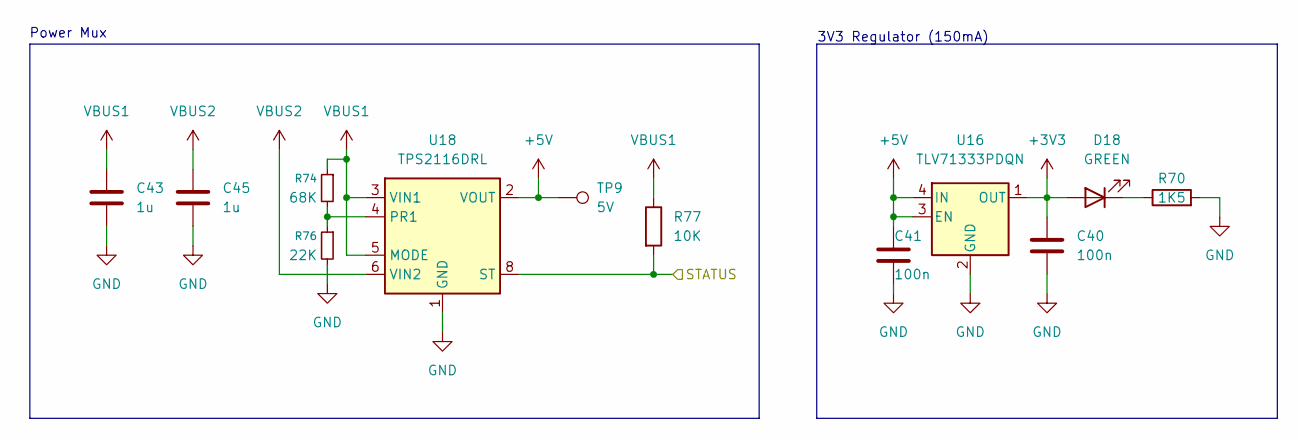
[picture p20: schematic regulator_onboard.kicad_sch]

Parts:
C40, C41: 100n; C_0603_1608Metric; LCSC C282519
C43, C45: 1u; C_0603_1608Metric
D18: GREEN; LED_0603_1608Metric; Part QBLP595-IG; LCSC C2856703
R70: 1K5; R_0402_1005Metric; LCSC C25930
R74: 68K; R_0402_1005Metric
R76: 22K; R_0402_1005Metric
R77: 10K; R_0402_1005Metric
TP9: 5V; TestPoint_Pad_1.0x1.0mm
U16: TLV71333PDQN; SOT-23-5; LCSC C2867340
U18: TPS2116DRL; SOT-583-8

Connections:
/REG_STATUS: R77.2, U18.8 (ST); also elsewhere on the board
unnamed: D18.1 (K), R70.1
unnamed: R74.2, R76.1, U18.4 (PR1)
VBUS1: C43.1, R74.1, R77.1, U18.3 (VIN1), U18.5 (MODE); also elsewhere on the board
VBUS2: C45.1, U18.6 (VIN2); also elsewhere on the board

Notes on the sheet:
3V3 Regulator (150mA)
Power Mux

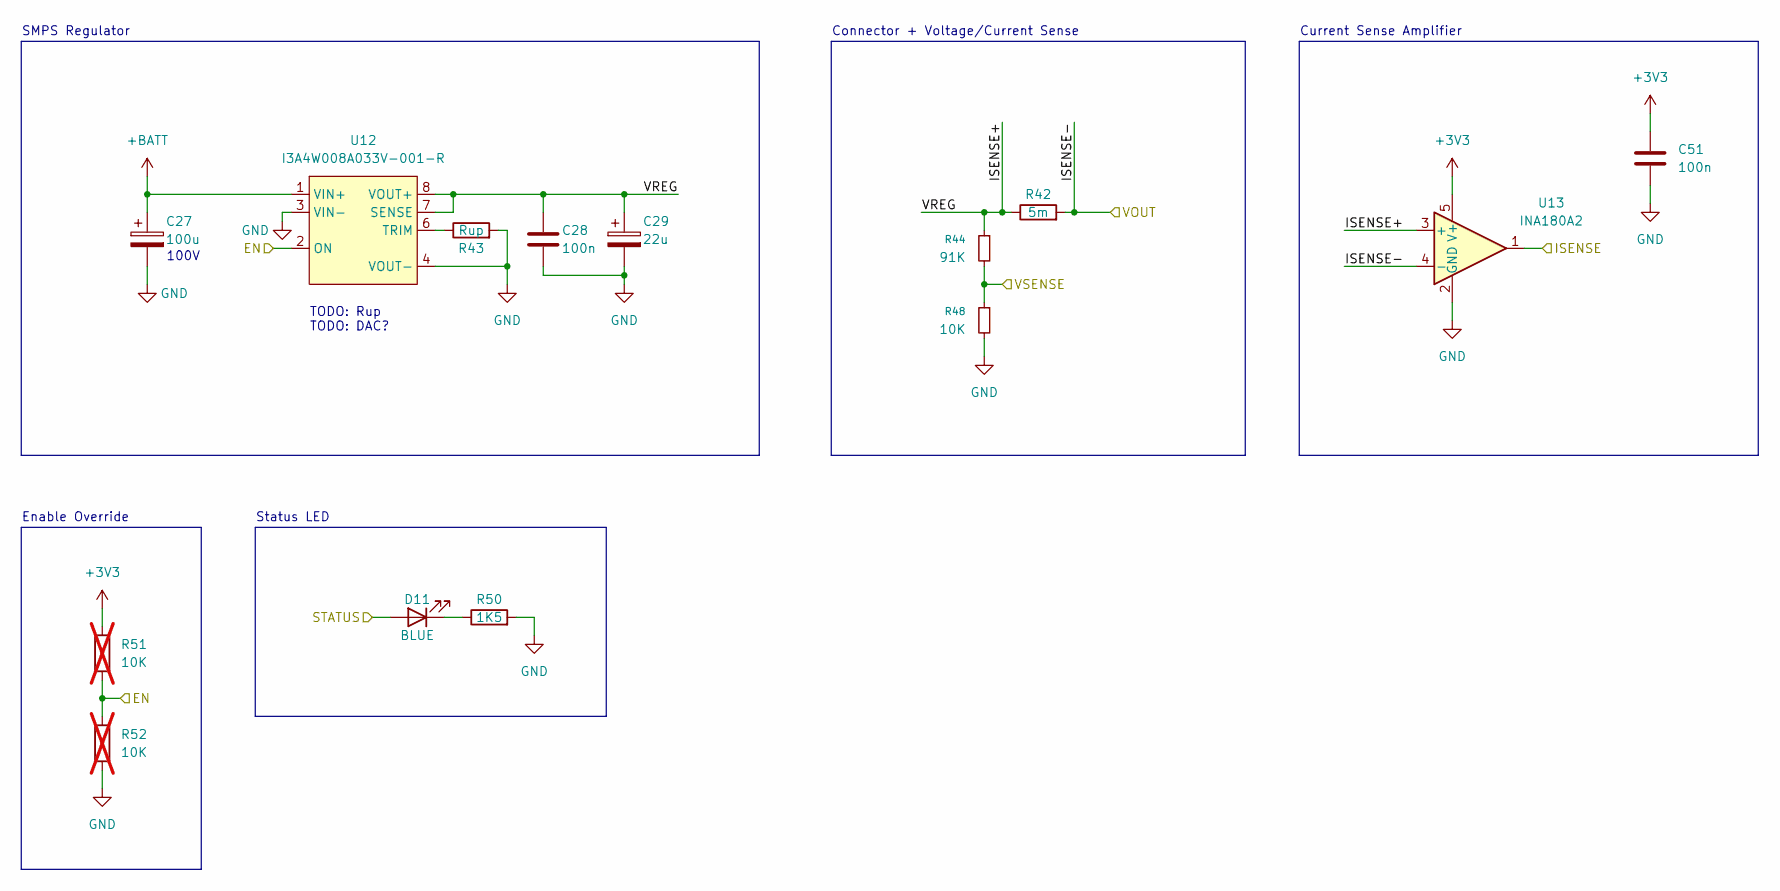
[picture p21: schematic regulator_highpower.kicad_sch]

Parts:
C27: 100u; C_1206_3216Metric
C28: 100n; C_0805_2012Metric
C29: 22u; C_0805_2012Metric
C51: 100n; C_0402_1005Metric
D11: BLUE; LED_0603_1608Metric
R42: 5m; R_1206_3216Metric
R43: Rup; R_0603_1608Metric
R44: 91K; R_0402_1005Metric
R48: 10K; R_0603_1608Metric
R50: 1K5; R_0402_1005Metric
R51, R52: 10K; R_0603_1608Metric; not fitted
U12: I3A4W008A033V-001-R; CONV_I3A4W008A033V-001-R
U13: INA180A2; SOT-23-5

Connections:
+BATT: C27.1, U12.1 (VIN+); also elsewhere on the board
/CM_EN: R51.2, R52.1, U12.2 (ON); also elsewhere on the board
/CM_ISENSE: U13.1; also elsewhere on the board
/CM_STATUS: D11.2 (A); also elsewhere on the board
/CM_VOUT: R42.2, U13.4 (-); also elsewhere on the board
/CM_VSENSE: R44.2, R48.1; also elsewhere on the board
/Compute Module Domain/ISENSE+: C28.1, C29.1, R42.1, R44.1, U12.7 (SENSE), U12.8 (VOUT+), U13.3 (+)
unnamed: D11.1 (K), R50.1
unnamed: R43.1, U12.6 (TRIM)

Notes on the sheet:
Enable Override
SMPS Regulator
Current Sense Amplifier
TODO: Rup TODO: DAC?
Status LED
Connector + Voltage/Current Sense
100V

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
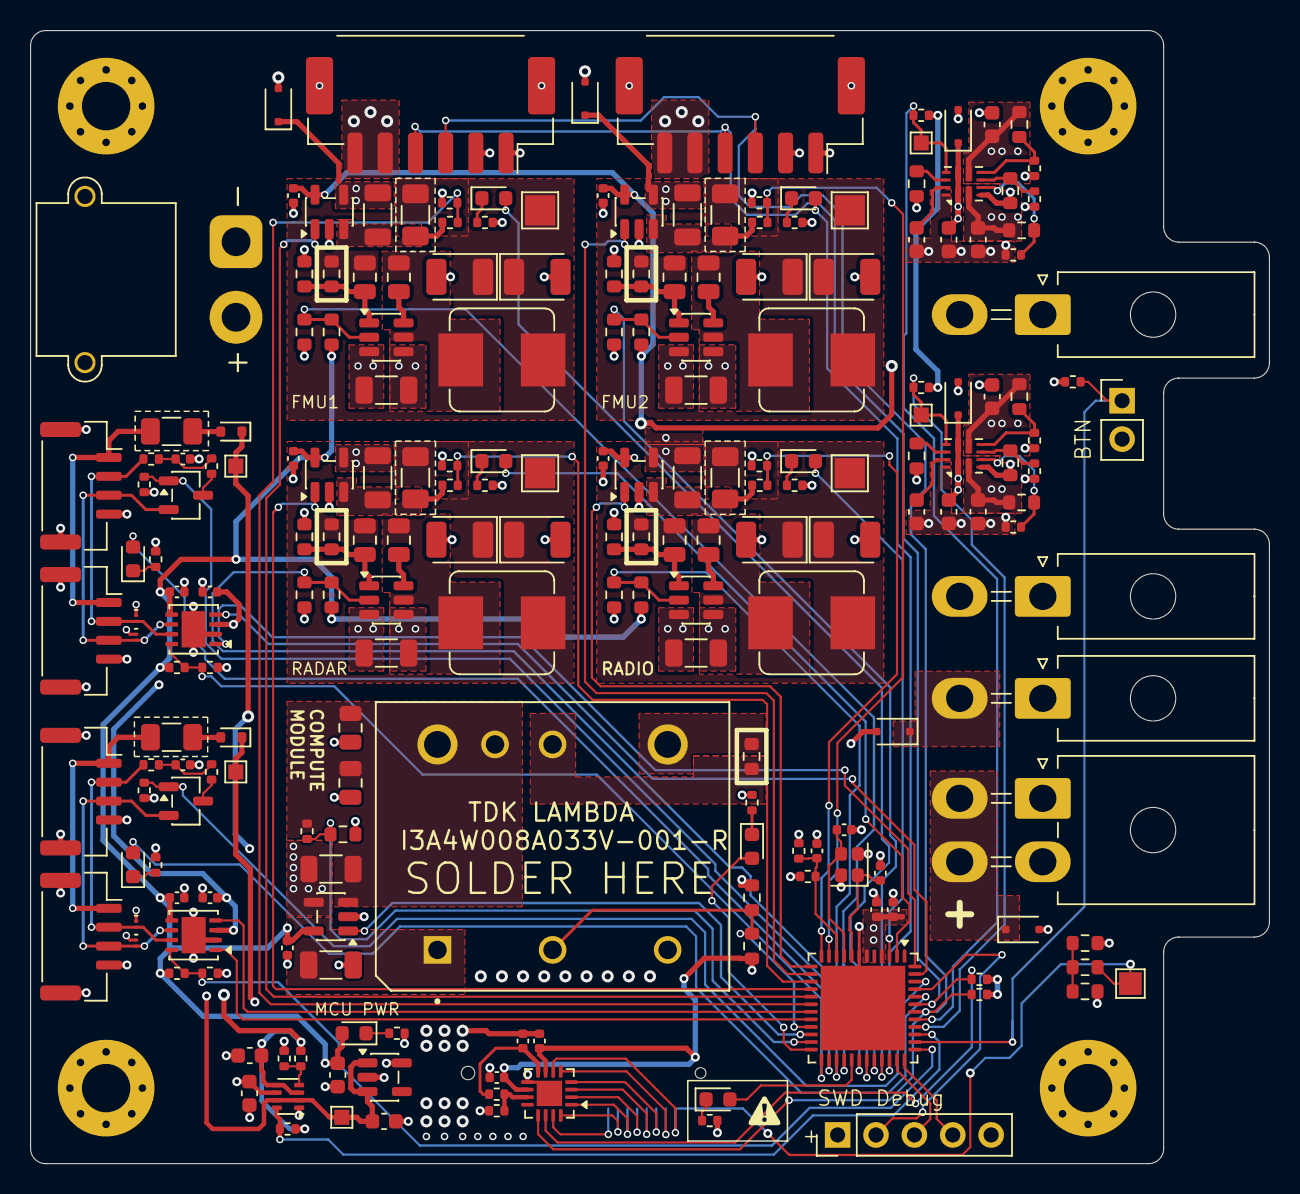
[picture p22: board vrb.kicad_pcb from above]

Board: 6 copper layers, 82.0 x 75.0 mm, 216 parts (1 on the bottom side), 121 nets.
