Poppy-Robotics/vrb/(commit log)

2025-12-29 nearly done with layout
    [can.kicad_sch, passthrough.kicad_sch, port.kicad_sch, rcc.kicad_sch, regulator_onboard.kicad_sch, vrb.kicad_pcb, vrb.kicad_sch]
2025-12-30 more layout work
    [vrb-B_Cu.gbr, vrb-B_Mask.gbr, vrb-B_Paste.gbr, vrb-B_Silkscreen.gbr, vrb-Edge_Cuts.gbr, vrb-F_Cu.gbr, vrb-F_Mask.gbr, vrb-F_Paste.gbr]
2026-01-09 fix capacitor sizes, clean up silkscreen, export
    [passthrough.kicad_sch, port.kicad_sch, regulator.kicad_sch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]
2026-01-10 minor revisions
    [passthrough.kicad_sch, regulator_highpower.kicad_sch, vrb.kicad_pcb, vrb.kicad_sch]
